BockajAndrej/AutomatedCentralHeating/README.md

# AutomatedCentralHeating

**Awarded 4th place in the national Student Professional Activity competition (SOČ) in the IT category (2022/2023).**

> All information about the product and its development can be found [here.](Dokumentacia)

## Final Products
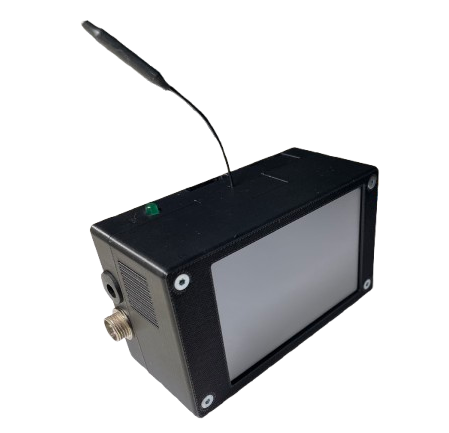
[picture p1: FOTO/Readme/MainUnitFront.png]

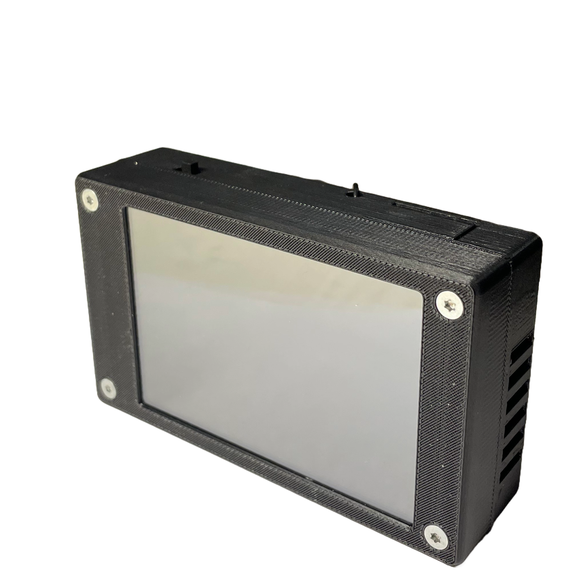
[picture p2: FOTO/Readme/SenderFront.png]


## Pages
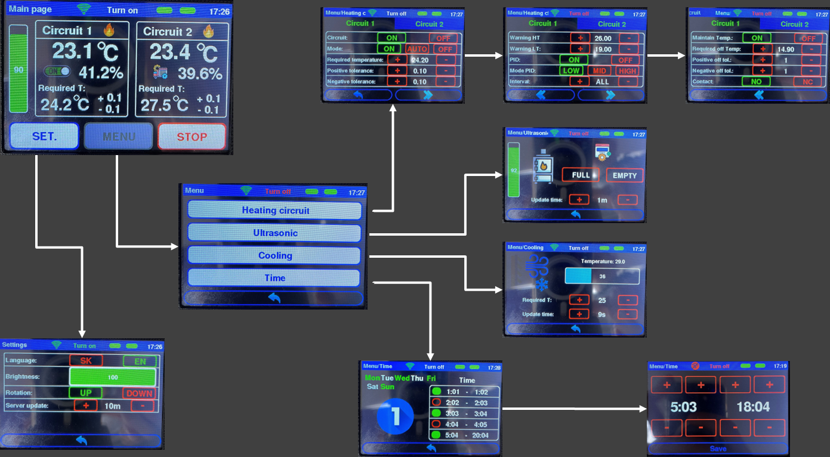
[picture p3: FOTO/Readme/pages.png]


## Algorithm diagrams

### Communication
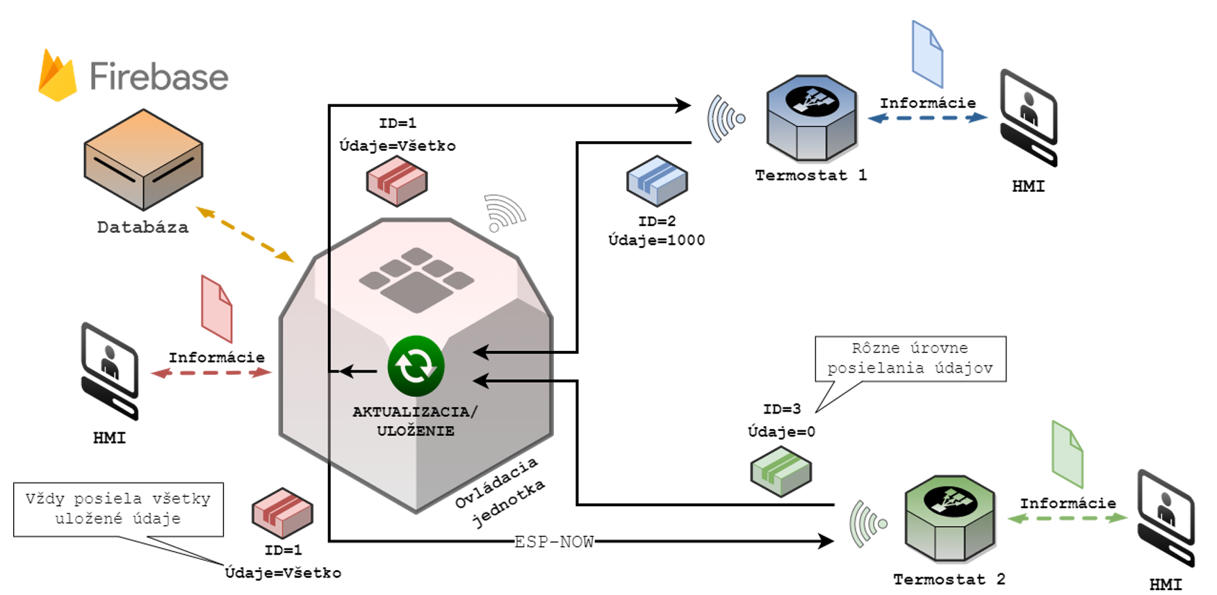
[picture p4: FOTO/Readme/Communication.png]

### PD regulation
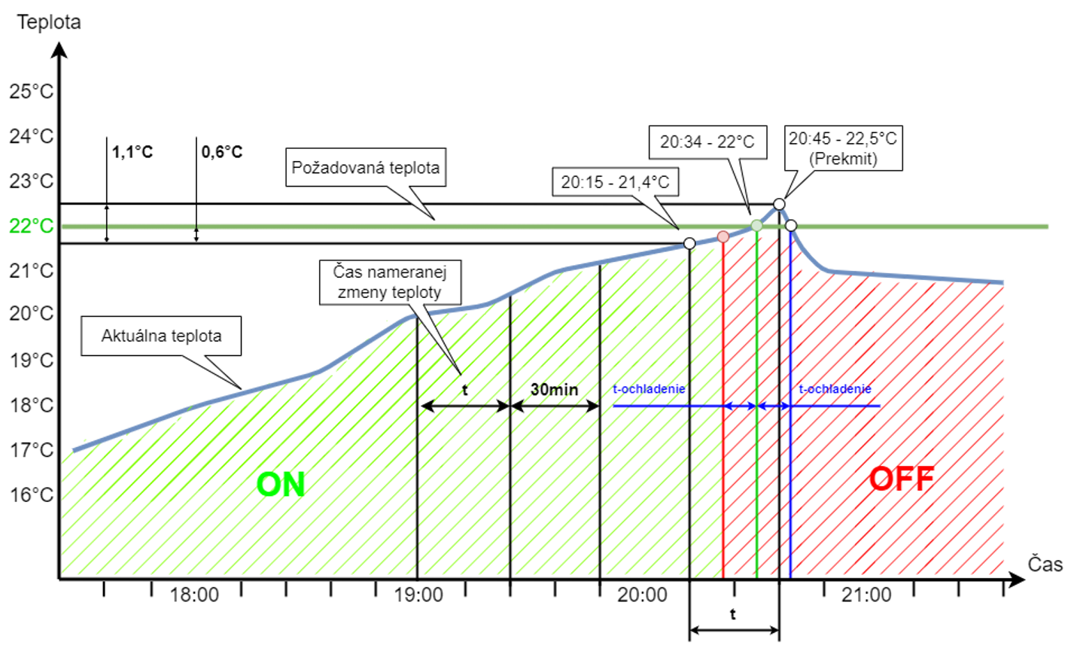
[picture p5: FOTO/Readme/PD_regulation.png]


## Program structure
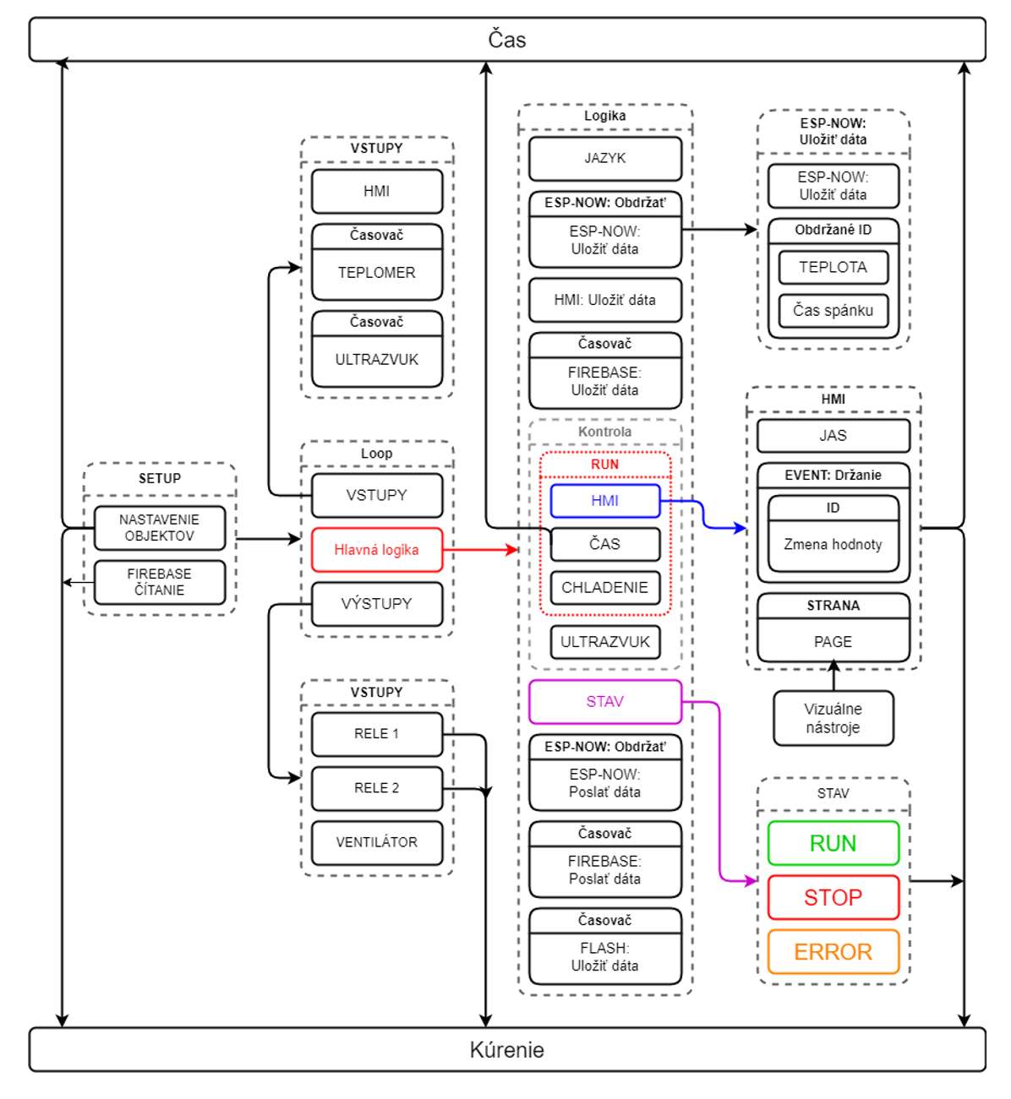
[picture p6: FOTO/Readme/ProgramStructure.png]


## DPS
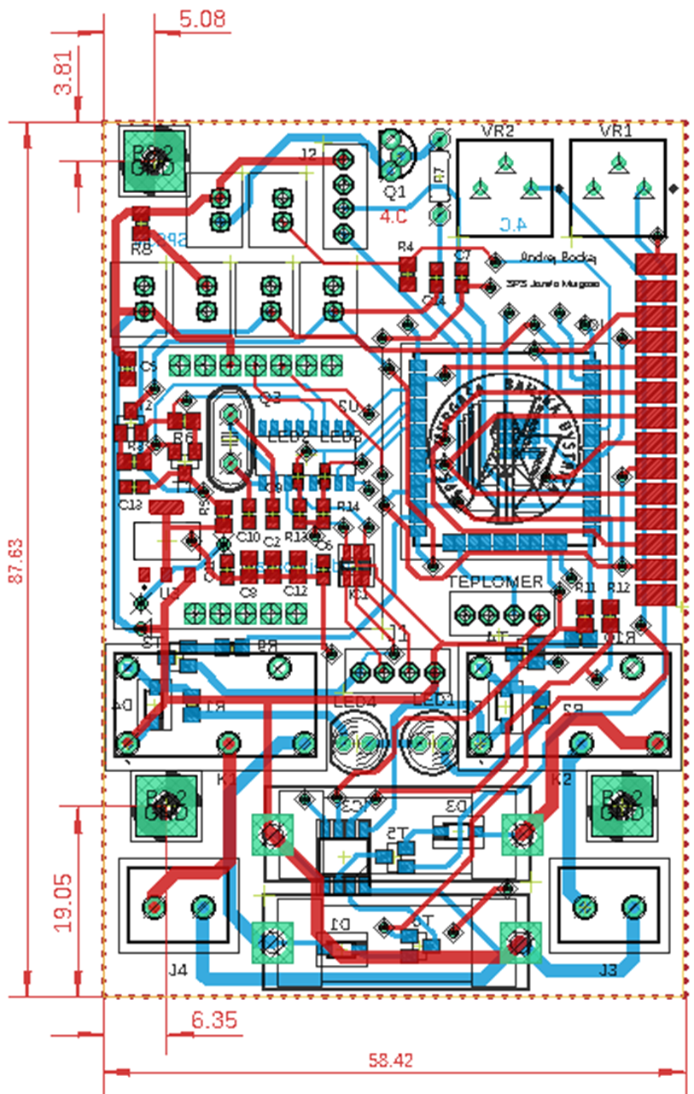
[picture p7: FOTO/Readme/MainUnitBrd.png]

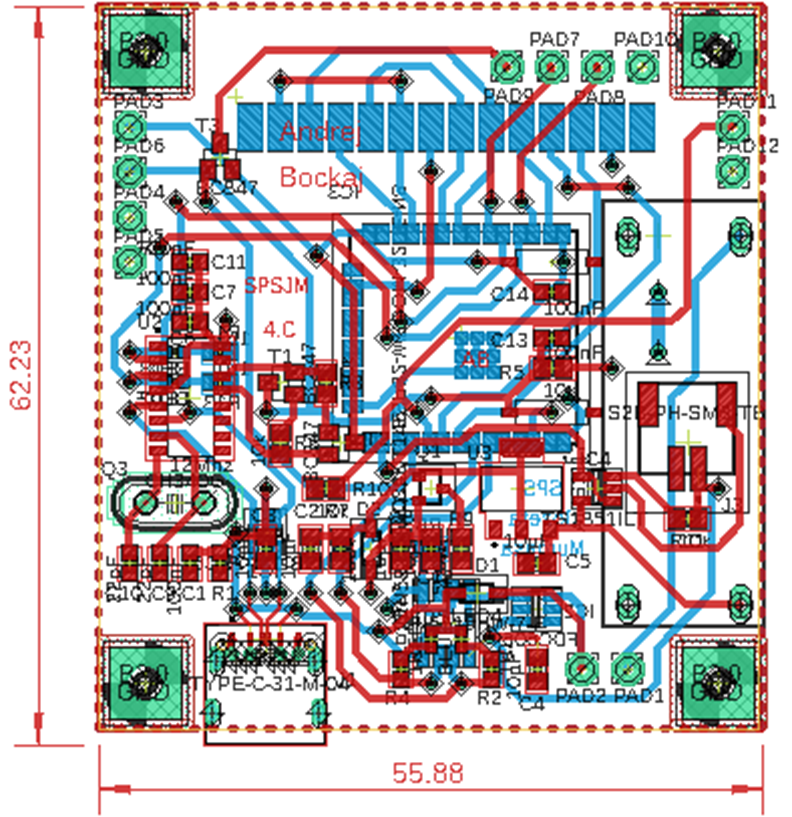
[picture p8: FOTO/Readme/SenderBrd.png]


## 3D models
### Main unit
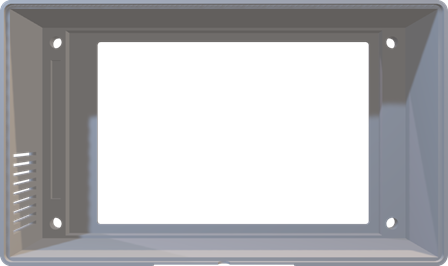
[picture p9: FOTO/Readme/MainUnitModelFront.png]

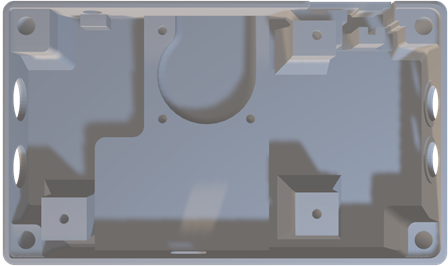
[picture p10: FOTO/Readme/MainUnitModelBack.png]

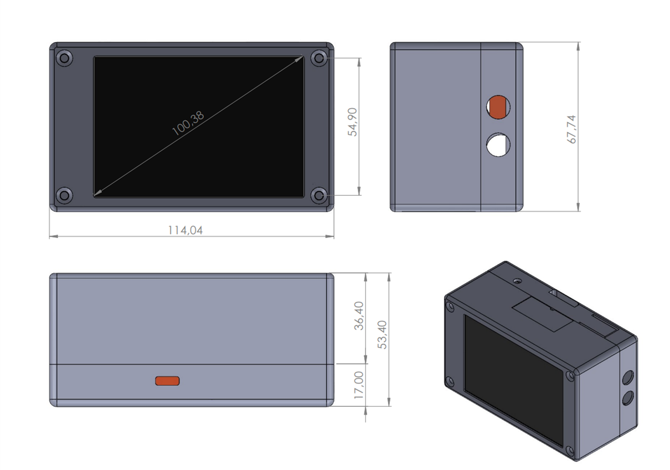
[picture p11: FOTO/Readme/MainUnitModelOut.png]


### Termostat
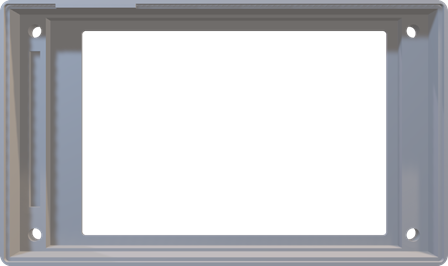
[picture p12: FOTO/Readme/SenderModelFront.png]

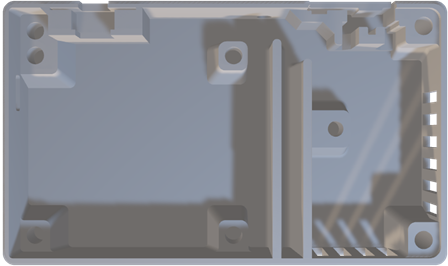
[picture p13: FOTO/Readme/SenderModelBack.png]

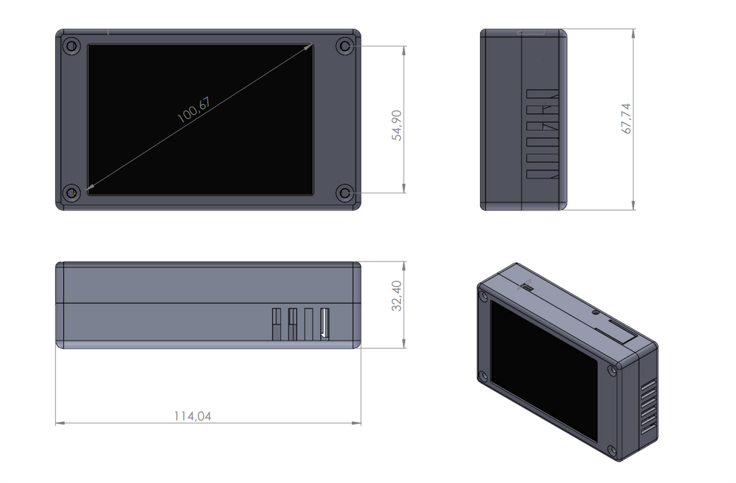
[picture p14: FOTO/Readme/SenderModelOut.png]


## Realisation
### Main unit
Popis prvého obrázka pre prístupnosť

### Termostat
Popis prvého obrázka pre prístupnosť
