BockajAndrej/AutomatedCentralHeating/Dokumentacia/Prezentácia SOČ.pdf

# ÚSTREDNÉHO KÚRENIA Krajské kolo SOČ

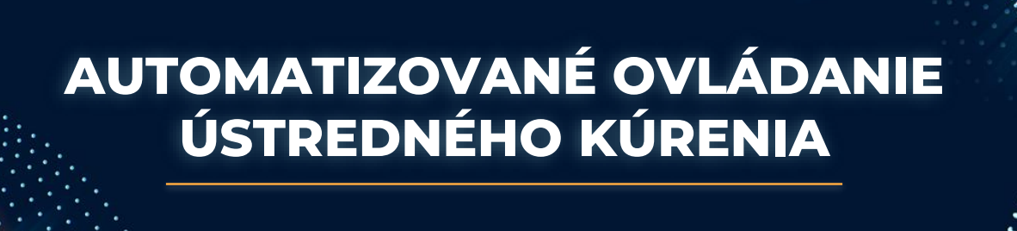
[picture p15: figure]
AUTOMATIZOVANÉ OVLÁDANIE ÚSTREDNÉHO KÚRENIA

Bočkaj Andrej 4.C SPŠ Jozefa Murgaša

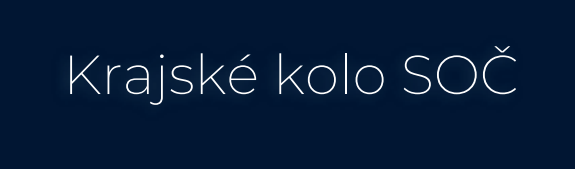
[picture p16: figure]
Krajské kolo SOČ

01

02 | 03 | 04
05

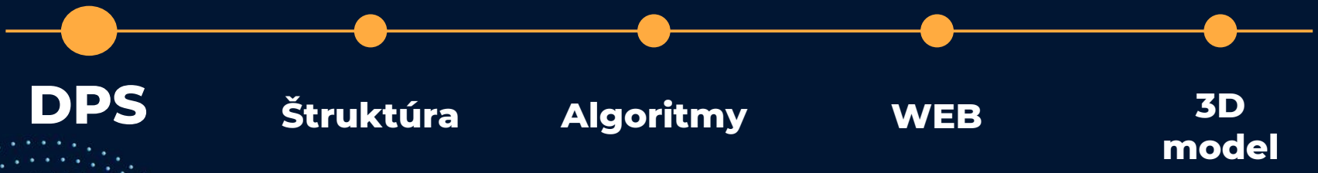
[picture p17: figure]
DPS; Štruktúra; Algoritmy; WEB; 3D model

01

# DPS

# DPS

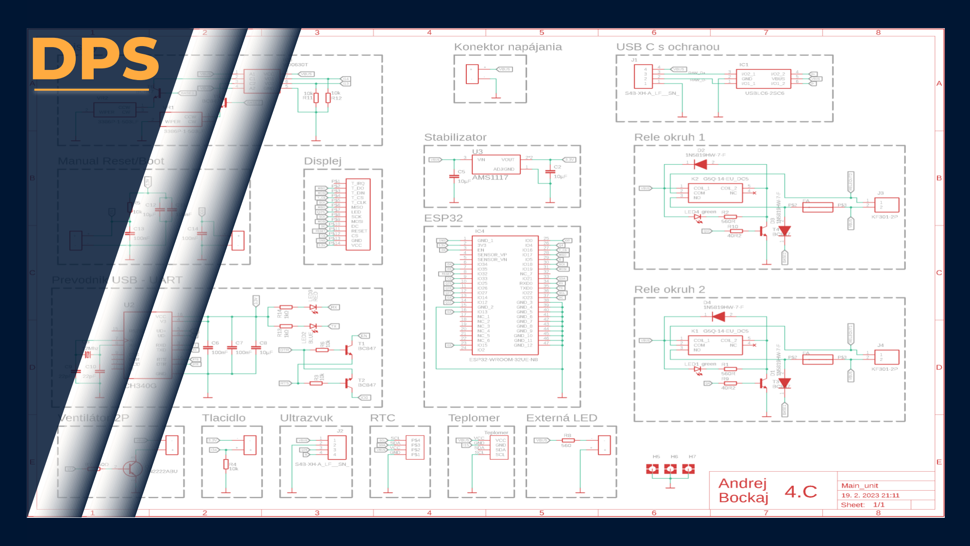
[picture p18: page 5]

# DPS

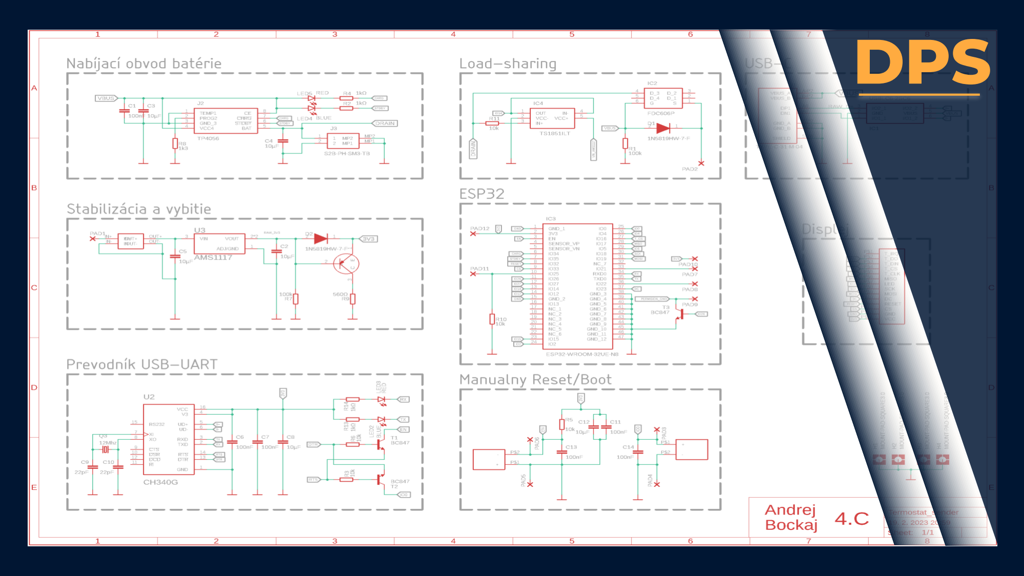
[picture p19: page 6]

01

02 | 03 | 04
05

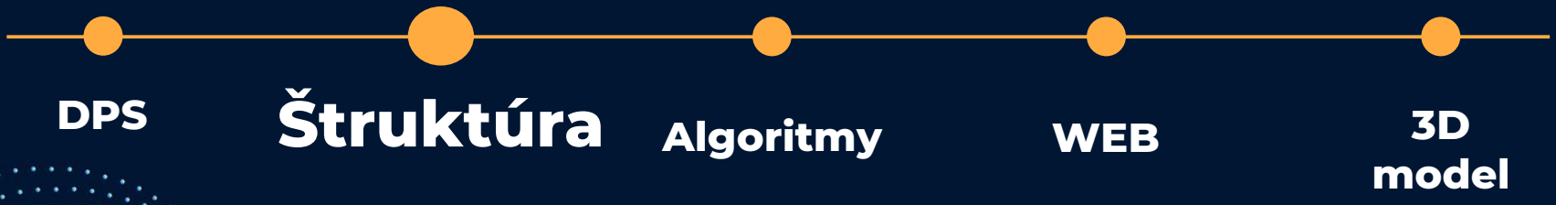
[picture p20: figure]
DPS; Štruktúra Algoritmy; WEB; 3D model

02

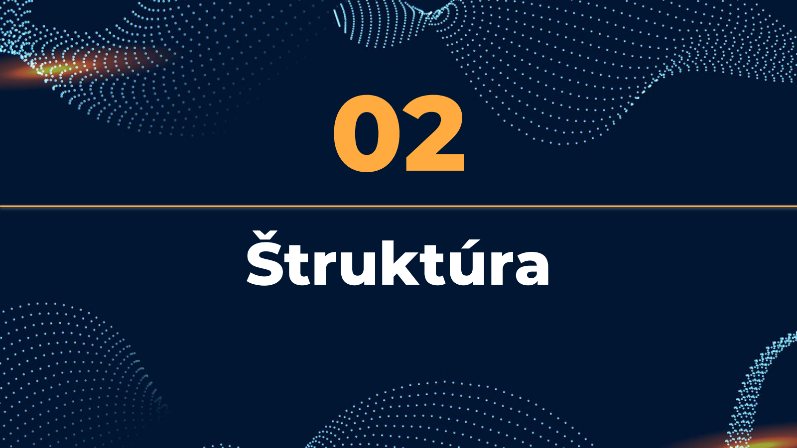
[picture p21: page 8]

# Štruktúra

## Štruktúra

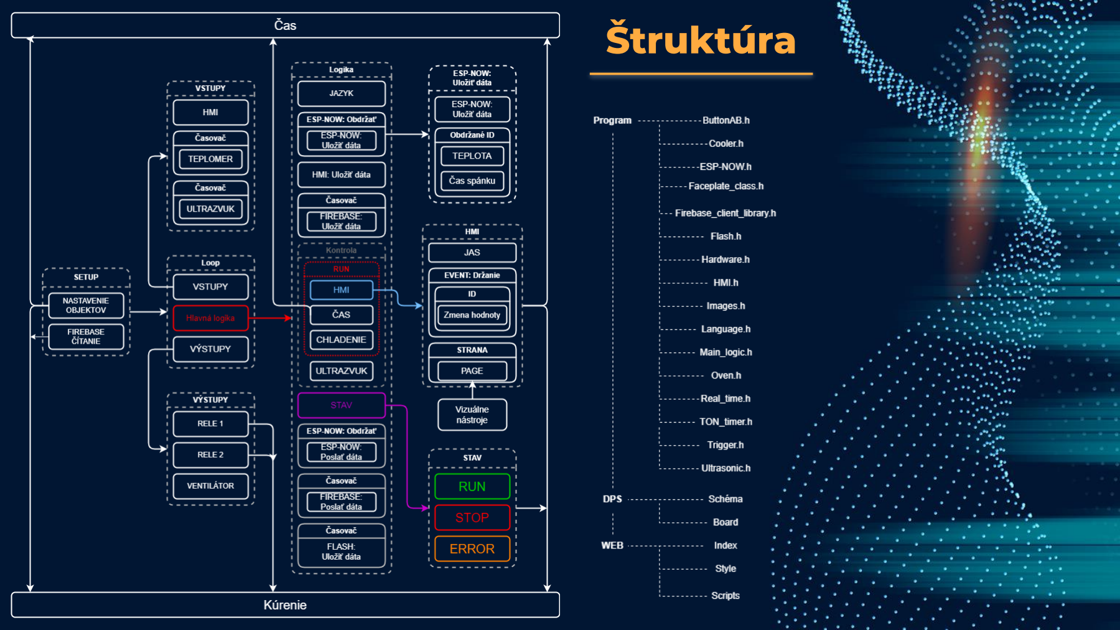
[picture p22: page 9]

02 | 03 | 04
05

01

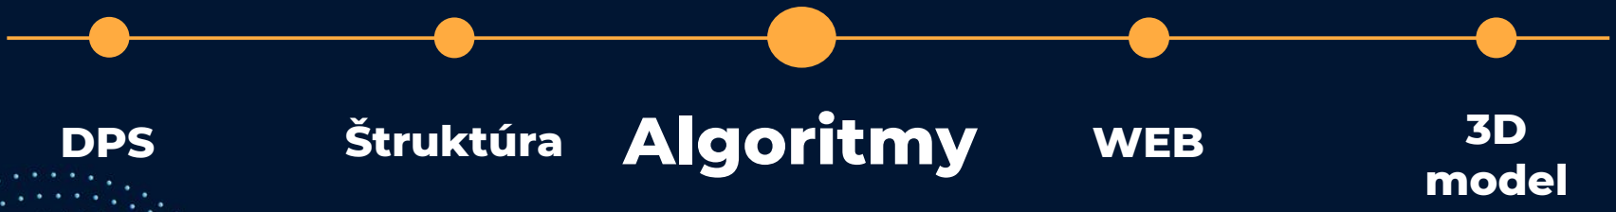
[picture p23: figure]
DPS; Štruktúra Algoritmy; WEB; 3D model

03

# Algoritmy

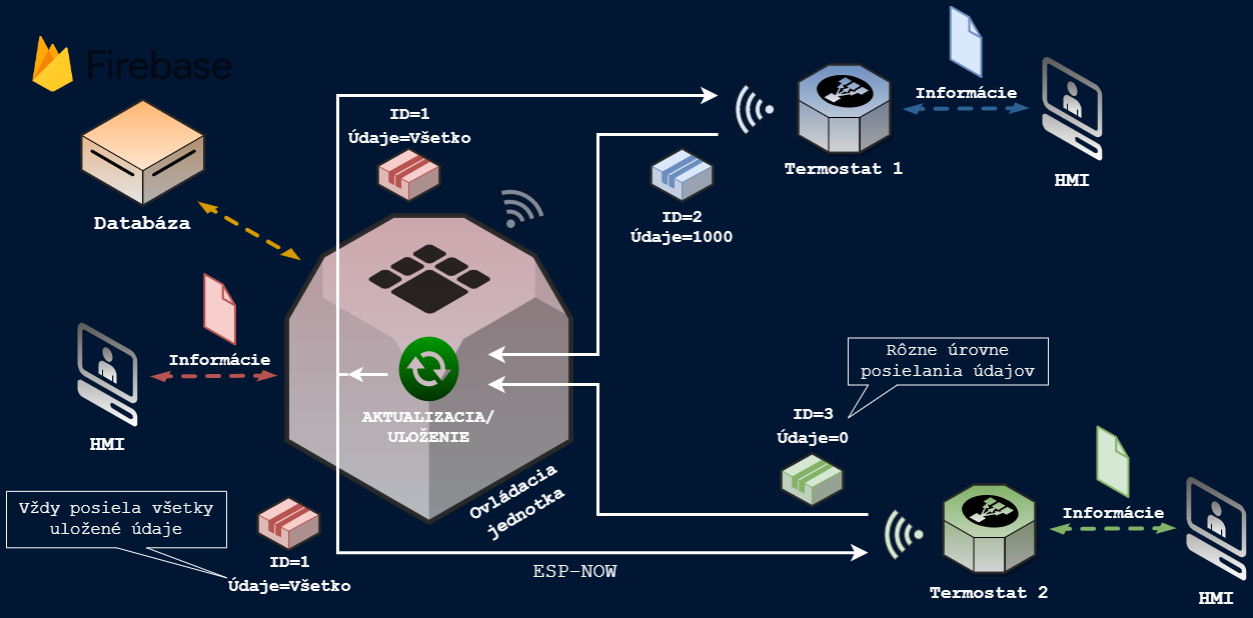
[picture p24: figure]
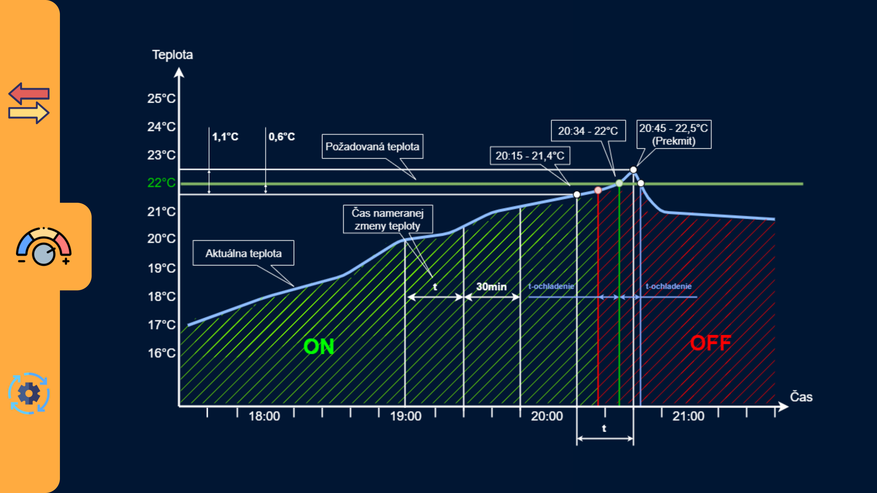
[picture p25: page 13]

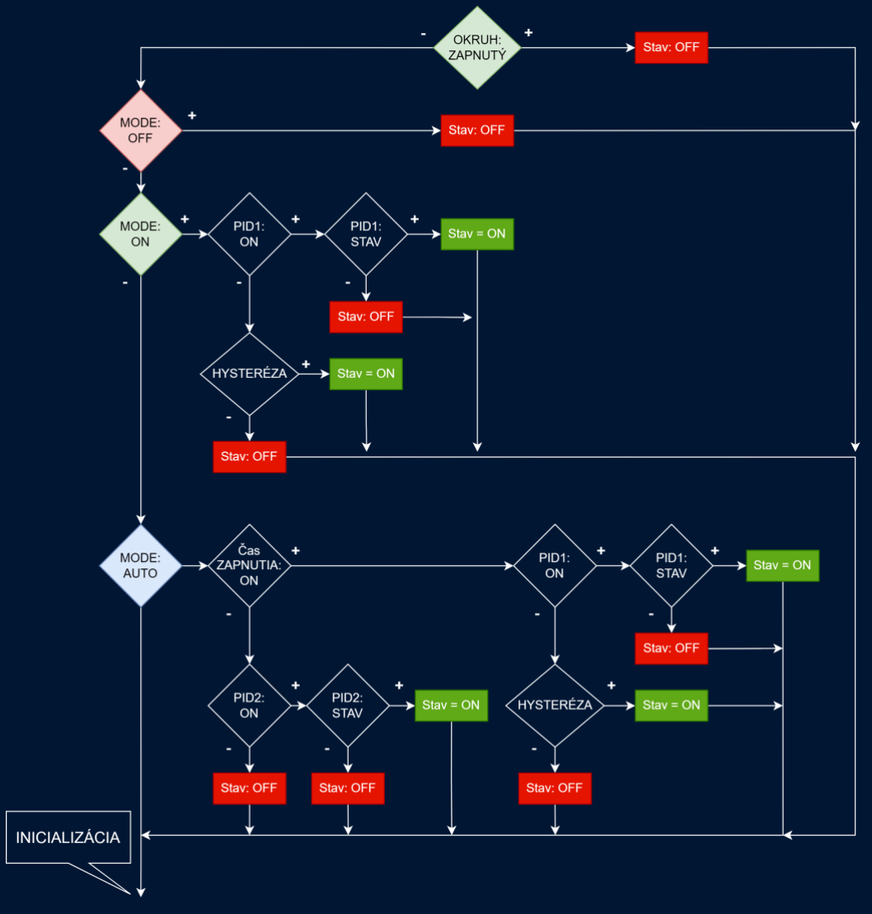
[picture p26: figure]

02 | 03 | 04
05

01

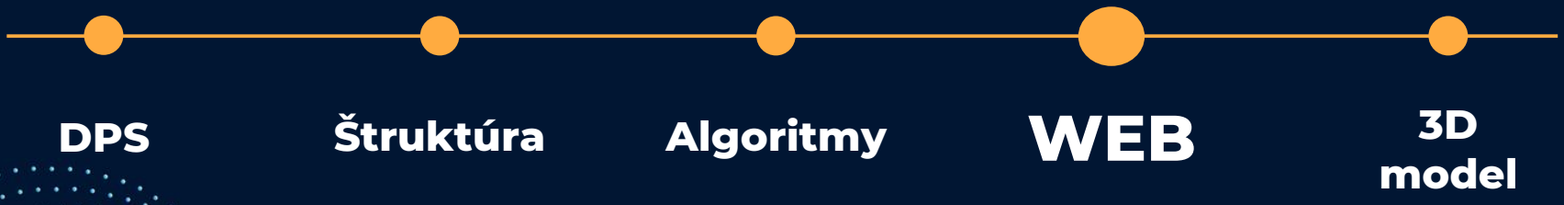
[picture p27: figure]
DPS; Štruktúra; Algoritmy; WEB; 3D model

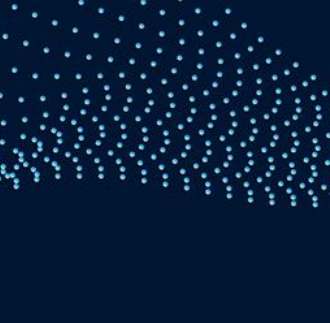
[picture p28: figure]

04

# WEB

# WEB

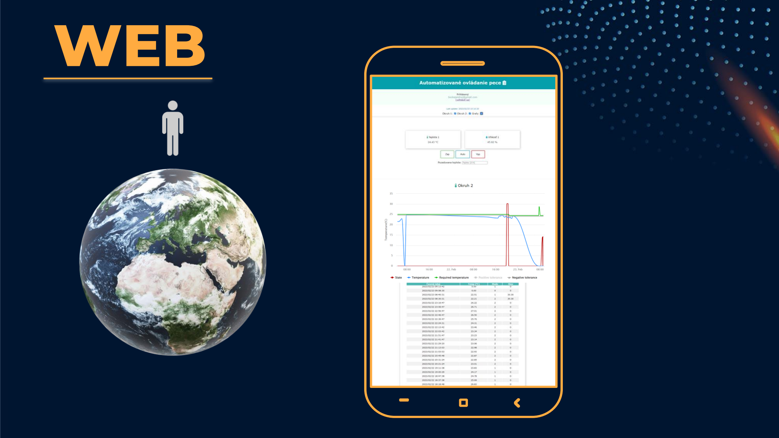
[picture p29: page 17]
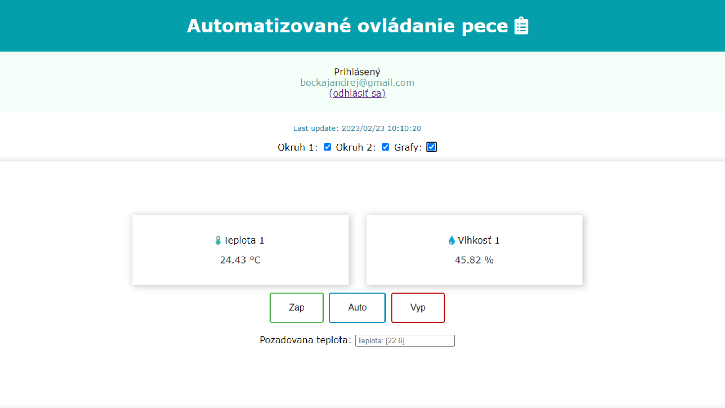
[picture p30: page 18]
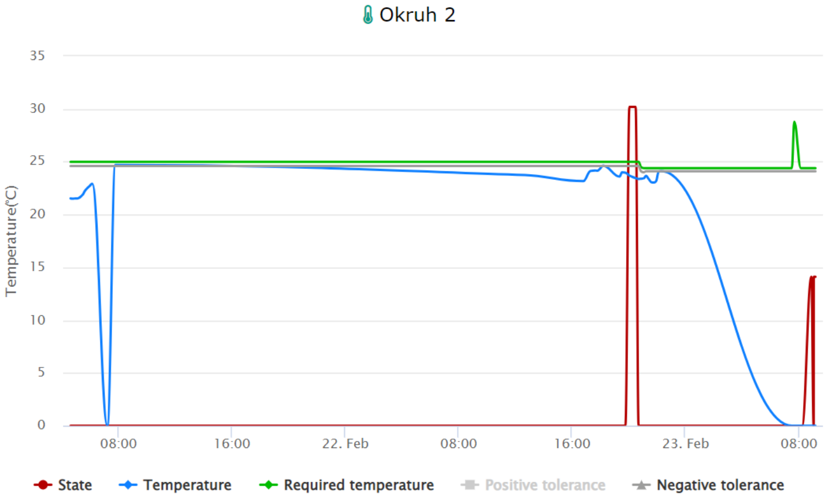
[picture p31: page 19]
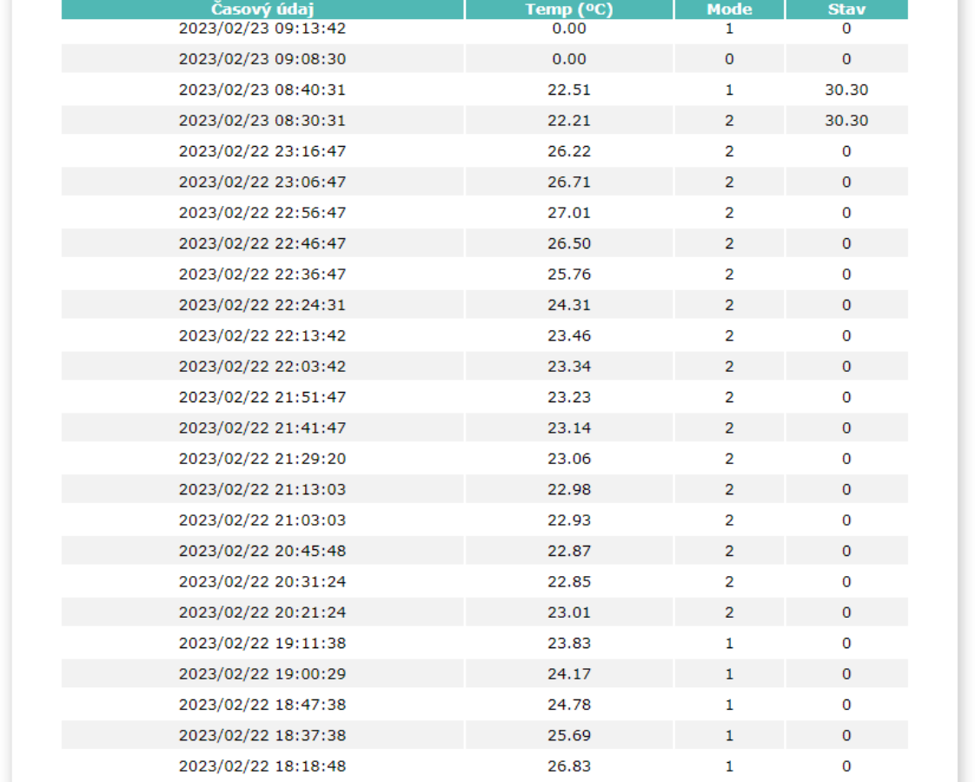
[picture p32: page 20]

DPS

02 | 03 | 04
Štruktúra | Algoritmy | WEB

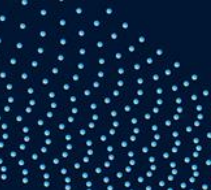
[picture p33: figure]

05

3D

## model

01

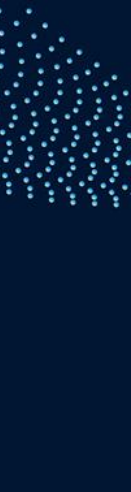
[picture p34: figure]

05

3D

# model

# 3D model

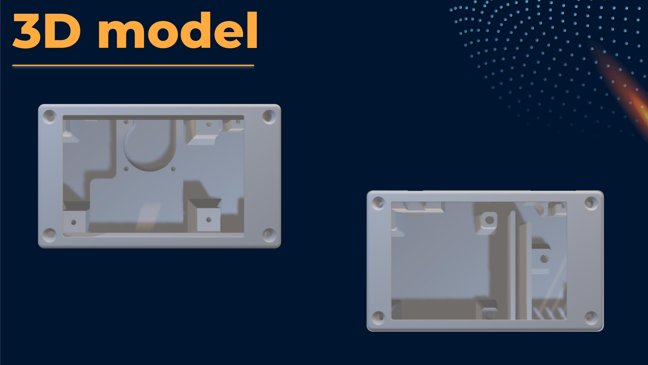
[picture p35: page 23]

# 3D model

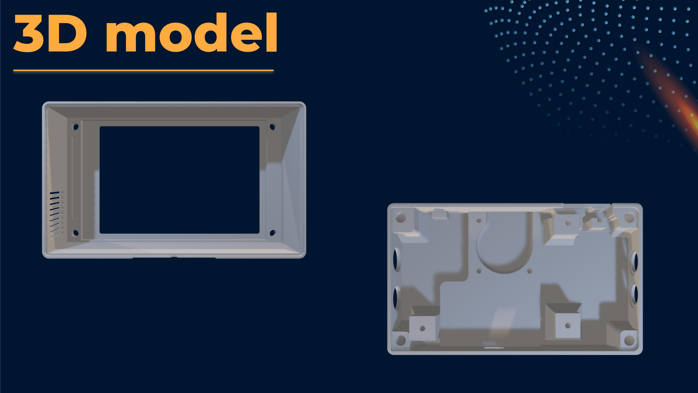
[picture p36: page 24]

# 3D model

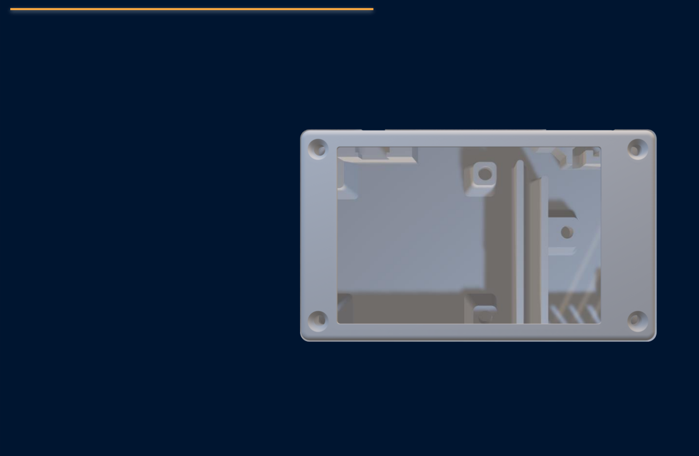
[picture p37: figure]

# 3D model

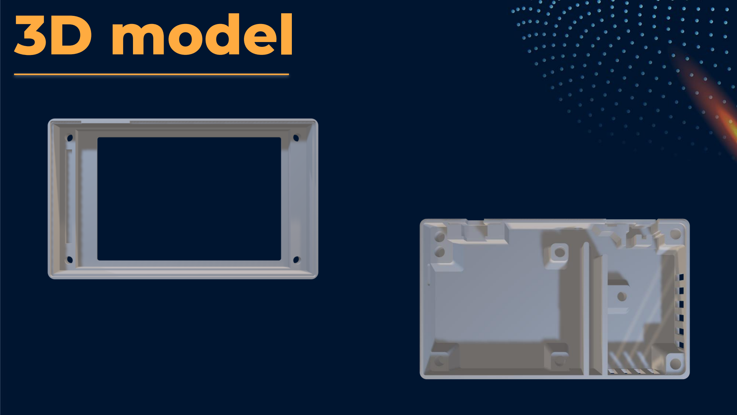
[picture p38: page 26]

# 3D model-Realizácia

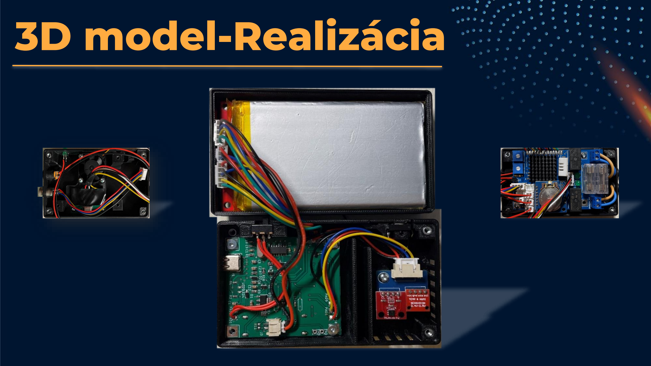
[picture p39: page 27]

# 3D model-Realizácia

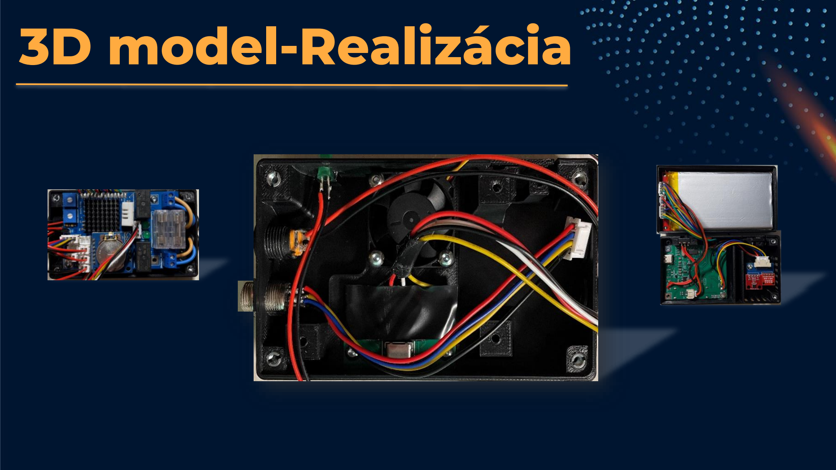
[picture p40: page 28]

# 3D model-Realizácia

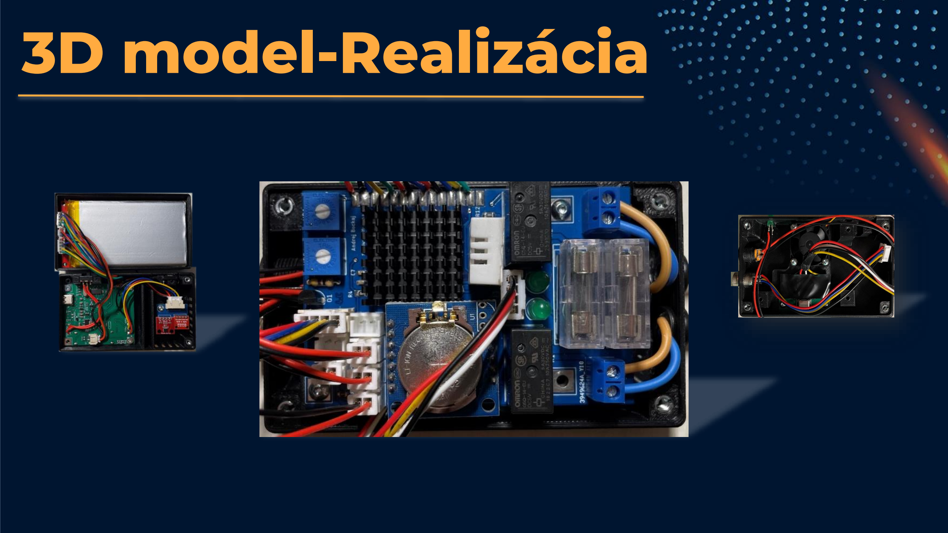
[picture p41: page 29]
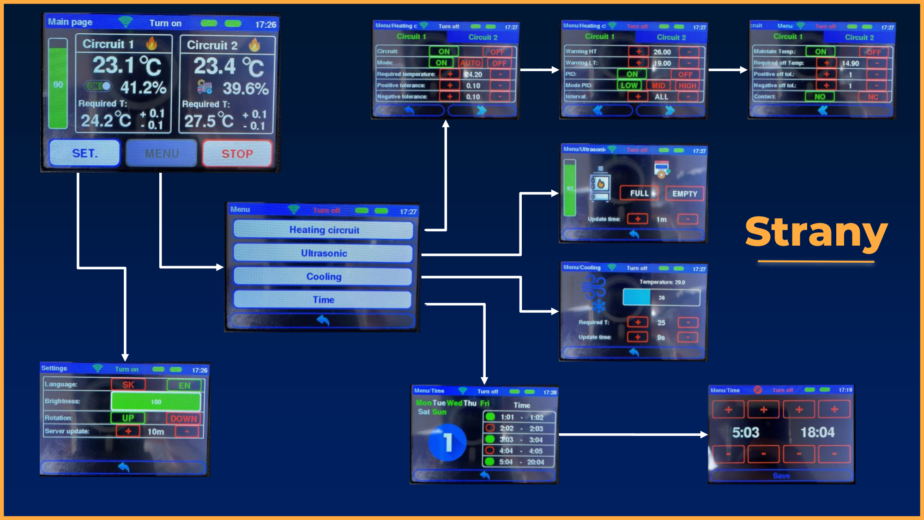
[picture p42: page 30]

# Strany

## Časová náročnosť vývoja zariadenia

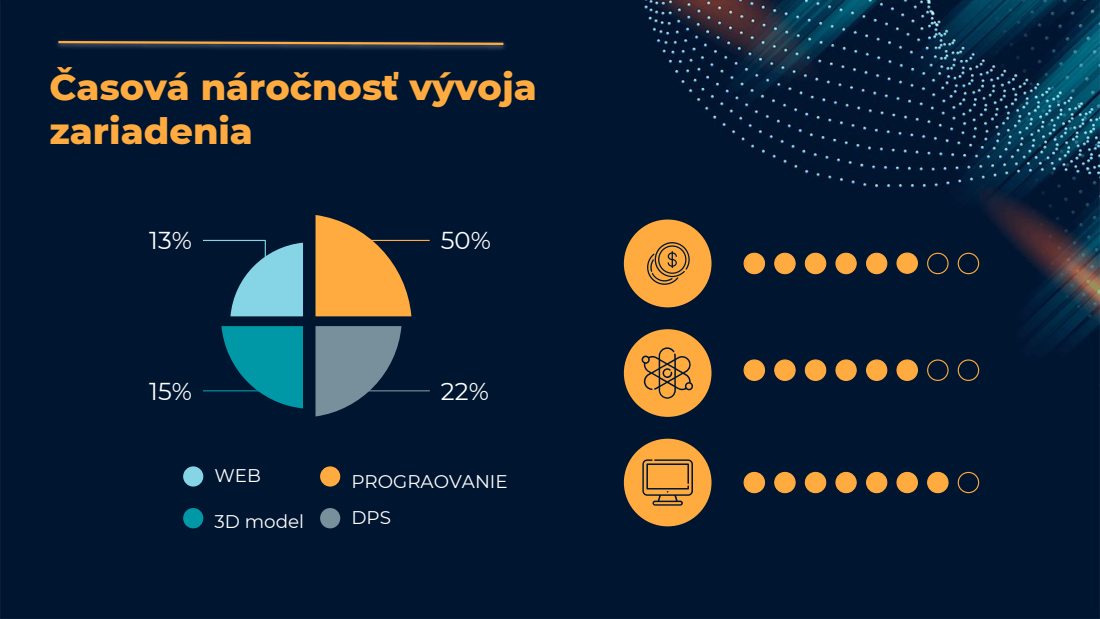
[picture p43: page 31]
PROGRAOVANIE; WEB; 3D model; DPS

# Ďakujem za pozornosť

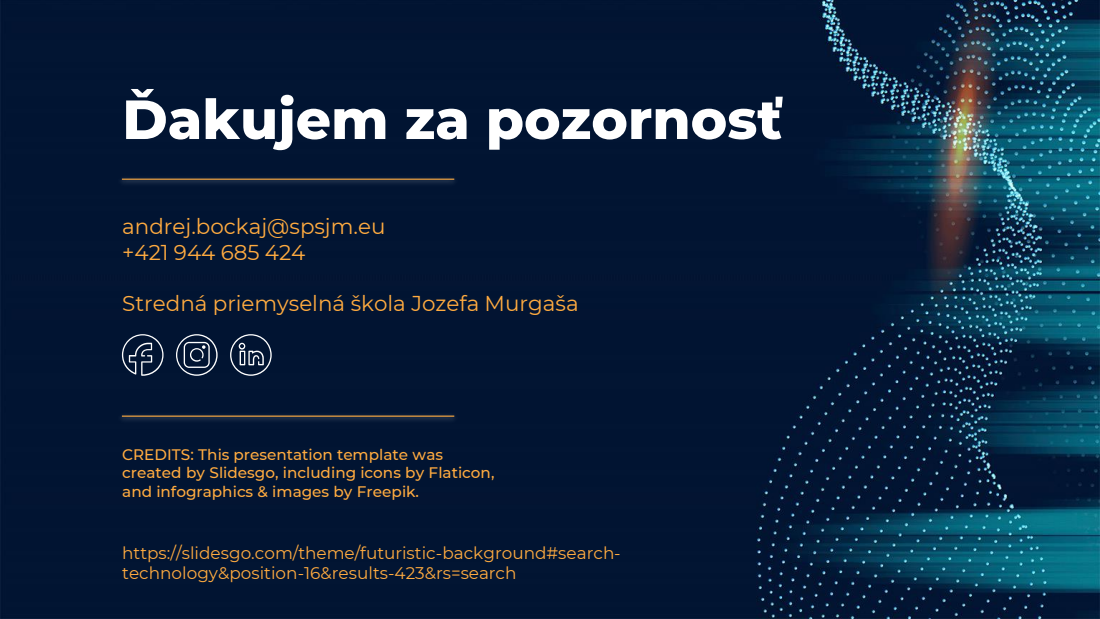
[picture p44: page 32]

andrej.bockaj@spsjm.eu

Stredná priemyselná škola Jozefa Murgaša

CREDITS: This presentation template was
created by Slidesgo, (http://bit.ly/2Tynxth) including icons by Flaticon, (http://bit.ly/2TyoMsr)
and infographics & images by Freepik. (http://bit.ly/2TtBDfr)

https://slidesgo.com/theme/futuristic-background#search-
technology&position-16&results-423&rs=search
