BockajAndrej/AutomatedCentralHeating/MAIN_PROGRAM/Main_unit_termostat0.2/HMI.h

#include "FS.h"
#include <TFT_eSPI.h>
#include <SPI.h>

#include "Images.h"

#include "Faceplate_Class.h"

#define CALIBRATION_FILE "/TouchCalData2"

class HMI {
private:
  TFT_eSPI* tft = new TFT_eSPI();
  TFT_eSprite* img = new TFT_eSprite(tft);
  TFT_eSprite* img_icon = new TFT_eSprite(tft);
  TFT_eSprite* img_background = new TFT_eSprite(tft);

  Time* real_time;
  Oven* oven_1;
  Oven* oven_2;
  Ultrasonic* ultrasonic;
  Cooler* cooler;
  ESP_NOW* esp_now;
  Flash* flash;
  ButtonAB* on_off_Btn;
  Firebase_class* firebase;

  Faceplate_Class* Faceplate = new Faceplate_Class(tft, img, img_icon, img_background);

  Language* Message = new Language();

  TON timer_for_touch = TON(200);

  int Wifi_connection;

  bool REPEAT_CAL;
  int Server_update_time;

  enum current_mode {
    Nominal_run = 1,
    Ground_position = 2,
    Error = 10
  };
  current_mode Current_mode;

  struct alarm {
    bool activated;
    Language* message = new Language();
  };
  alarm Alarm;

  struct display_property {
    int Width;
    int Height;
    int LOOP_PERIOD;
    short Rotation;
    int Text_color;
    unsigned long UpdateTimeHMI_LOOP;
    bool first_draw;
    unsigned long Refresh_time;
    struct Pressing_struct {
      int Enable_timer;
      unsigned long Time;
      int Count;
      int ID;
    };
    Pressing_struct Pressing;
    struct Brightness_struct {
      int Pin;
      int PWMfreq;
      int PWMChannel;
      int PWMresolution;
      int Value;
    };
    Brightness_struct Brightness;
    struct color {
      int Transparent[3] = { 999, 999, 999 };
      int Background[3];
      int Text[3];
      int Focused[3];
      int Red[3] = { 255, 0, 0 };
      int Green[3] = { 0, 255, 0 };
      int Lite_blue[3] = { 0, 165, 255 };
      int Blue[3] = { 0, 0, 255 };
      int Dark_blue[3] = { 0, 0, 153 };
      int Black[3] = { 0, 0, 0 };
      int White[3] = { 255, 255, 255 };
      int Yellow[3] = { 255, 255, 0 };
      int Orange[3] = { 255, 100, 0 };
    };
    color Color;
  };
  display_property Property;

  enum Page {
    Main_page = 1,
    Menu = 2,
    Settings = 3,
    Heating_circruit_ = 10,
    Ultrasonic_ = 11,
    Temperature_sensor_ = 12,
    Time_ = 13
  };
  Page page;
  Page prev_page;

public:
  HMI(Time* real_time, Oven* oven_1, Oven* oven_2, Ultrasonic* ultrasonic, Cooler* cooler, ESP_NOW* esp_now, Flash* flash, ButtonAB* on_off_Btn, Firebase_class* firebase) {
    this->real_time = real_time;
    this->oven_1 = oven_1;
    this->oven_2 = oven_2;
    this->ultrasonic = ultrasonic;
    this->cooler = cooler;
    this->esp_now = esp_now;
    this->flash = flash;
    this->on_off_Btn = on_off_Btn;
    this->firebase = firebase;

    page = Main_page;
    prev_page = Menu;

    Alarm.activated = false;

    REPEAT_CAL = false;
    Server_update_time = 10;

    Property.UpdateTimeHMI_LOOP = 0;
    Property.LOOP_PERIOD = 20;
    Property.Width = 480;
    Property.Height = 320;
    Property.Rotation = 3;
    Property.first_draw = true;

    Property.Pressing.Time = 0;
    Property.Pressing.Enable_timer = false;

    Property.Brightness.PWMfreq = 5000;
    Property.Brightness.PWMChannel = 1;
    Property.Brightness.PWMresolution = 8;
    Property.Brightness.Value = 255;

    Property.Color.Transparent[0] = 999;
    Property.Color.Background[0] = 0;
    Property.Color.Background[1] = 0;
    Property.Color.Background[2] = 0;
    Property.Color.Text[0] = 255;
    Property.Color.Text[1] = 255;
    Property.Color.Text[2] = 255;
    Property.Color.Focused[0] = 0;
    Property.Color.Focused[1] = 255;
    Property.Color.Focused[2] = 0;

    Touch.x = 0;
    Touch.y = 0;
    Touch.raw_Pressed = false;
    Touch.UpdateTimeHMI_Touch = 0;
    Touch.Pressed = false;
    Touch.prev_Pressed = Touch.Pressed;
    Touch.Pressing_period = 80;
    Touch.Releast = false;

    Settings_str.prev_language = Message->get_language();

    TopBar.Height = 30;

    MainPage.prev_heating_1 = oven_1->get_Heating();
    MainPage.prev_heating_2 = oven_2->get_Heating();

    Settings_str.Reset_value = 1;

    Heating_circuit.Circuit = true;
    Heating_circuit.prev_Circuit = Heating_circuit.Circuit;
    Heating_circuit.Page = 1;

    Time_Struct.Page_ = true;
  }
  void Setup(int Pin) {
    // configure LED PWM functionalitites
    ledcSetup(Property.Brightness.PWMChannel, Property.Brightness.PWMfreq, Property.Brightness.PWMresolution);
    // attach the channel to the GPIO to be controlled
    ledcAttachPin(Pin, Property.Brightness.PWMChannel);

    ledcWrite(Property.Brightness.PWMChannel, Property.Brightness.Value);

    Property.Brightness.Pin = Pin;

    tft->init();
    tft->setSwapBytes(true);
    img->setColorDepth(8);  // Set colour depth of Sprite to 8 (or 16) bits
    img_icon->setSwapBytes(true);

    Property.Rotation = flash->get_Flash(44);
    tft->setRotation(Property.Rotation);

    // Calibrate the touch screen and retrieve the scaling factors
    REPEAT_CAL = (bool)flash->get_Flash(45);
    touch_calibrate();
    REPEAT_CAL = false;
    if ((bool)flash->get_Flash(45)) flash->set_Flash(45, REPEAT_CAL);

    tft->setTextSize(1);
    tft->setTextColor(tft->color565(Property.Color.Text[0], Property.Color.Text[1], Property.Color.Text[2]), tft->color565(Property.Color.Background[0], Property.Color.Background[1], Property.Color.Background[2]));
    tft->fillScreen(tft->color565(Property.Color.Background[0], Property.Color.Background[1], Property.Color.Background[2]));

    Current_mode = (HMI::current_mode)flash->get_Flash(0);
    if (flash->get_Flash(1)) Message->Set_language("EN");
    else Message->Set_language("SK");

    Server_update_time = flash->get_Flash(49);

    Property.UpdateTimeHMI_LOOP = millis();
    Touch.UpdateTimeHMI_Touch = millis();
    Property.Refresh_time = millis();
  }
  bool Refresh(bool Draw, int Wifi_connection) {

    this->Wifi_connection = Wifi_connection;

    if ((Current_mode == Nominal_run) && (page != Settings)) page = Main_page;

    ledcWrite(Property.Brightness.PWMChannel, Property.Brightness.Value);

    if (Draw) Property.first_draw = true;

    if (((Property.Pressing.Time + Property.Pressing.Count) <= millis()) && Property.Pressing.Enable_timer) {
      switch (Property.Pressing.ID) {
        case 1:
          if (Heating_circuit.Circuit) oven_1->set_Required_T(oven_1->get_Required_T() + 0.1);
          else oven_2->set_Required_T(oven_2->get_Required_T() + 0.1);
          break;
        case 2:
          if (Heating_circuit.Circuit) oven_1->set_Required_T(oven_1->get_Required_T() - 0.1);
          else oven_2->set_Required_T(oven_2->get_Required_T() - 0.1);
          break;
        case 3:
          if (Heating_circuit.Circuit) oven_1->set_Positive_tolerance(oven_1->get_Positive_tolerance() + 0.1);
          else oven_2->set_Positive_tolerance(oven_2->get_Positive_tolerance() + 0.1);
          break;
        case 4:
          if (Heating_circuit.Circuit) oven_1->set_Positive_tolerance(oven_1->get_Positive_tolerance() - 0.1);
          else oven_2->set_Positive_tolerance(oven_2->get_Positive_tolerance() - 0.1);
          break;
        case 5:
          if (Heating_circuit.Circuit) oven_1->set_Negative_tolerance(oven_1->get_Negative_tolerance() + 0.1);
          else oven_2->set_Negative_tolerance(oven_2->get_Negative_tolerance() + 0.1);
          break;
        case 6:
          if (Heating_circuit.Circuit) oven_1->set_Negative_tolerance(oven_1->get_Negative_tolerance() - 0.1);
          else oven_2->set_Negative_tolerance(oven_2->get_Negative_tolerance() - 0.1);
          break;
        case 7:
          if (Heating_circuit.Circuit) oven_1->set_Upper_limit(oven_1->get_Upper_limit() + 1);
          else oven_2->set_Upper_limit(oven_2->get_Upper_limit() + 1);
          break;
        case 8:
          if (Heating_circuit.Circuit) oven_1->set_Upper_limit(oven_1->get_Upper_limit() - 1);
          else oven_2->set_Upper_limit(oven_2->get_Upper_limit() - 1);
          break;
        case 9:
          if (Heating_circuit.Circuit) oven_1->set_Lower_limit(oven_1->get_Lower_limit() + 1);
          else oven_2->set_Lower_limit(oven_2->get_Lower_limit() + 1);
          break;
        case 10:
          if (Heating_circuit.Circuit) oven_1->set_Lower_limit(oven_1->get_Lower_limit() - 1);
          else oven_2->set_Lower_limit(oven_2->get_Lower_limit() - 1);
          break;
        case 21:
          if (Property.Pressing.Count < 250) {
            Time_Struct.Page_ = false;
            Time_Struct.ID = 0;
          }
          break;
        case 22:
          if (Property.Pressing.Count < 250) {
            Time_Struct.Page_ = false;
            Time_Struct.ID = 1;
          }
          break;
        case 23:
          if (Property.Pressing.Count < 250) {
            Time_Struct.Page_ = false;
            Time_Struct.ID = 2;
          }
          break;
        case 24:
          if (Property.Pressing.Count < 250) {
            Time_Struct.Page_ = false;
            Time_Struct.ID = 3;
          }
          break;
        case 25:
          if (Property.Pressing.Count < 250) {
            Time_Struct.Page_ = false;
            Time_Struct.ID = 4;
          }
          break;
        case 26:
          if (Property.Pressing.Count < 250) {
            Time_Struct.Page_ = false;
            Time_Struct.ID = 0;
          }
          break;
        case 27:
          if (Property.Pressing.Count < 250) {
            Time_Struct.Page_ = false;
            Time_Struct.ID = 1;
          }
          break;
        case 28:
          if (Property.Pressing.Count < 250) {
            Time_Struct.Page_ = false;
            Time_Struct.ID = 2;
          }
          break;
        case 29:
          if (Property.Pressing.Count < 250) {
            Time_Struct.Page_ = false;
            Time_Struct.ID = 3;
          }
          break;
        case 30:
          if (Property.Pressing.Count < 250) {
            Time_Struct.Page_ = false;
            Time_Struct.ID = 4;
          }
          break;
        case 31:
          real_time->set_Interval_heating(Time_Struct.Which, true, Time_Struct.ID, (real_time->get_Interval_heating(Time_Struct.Which, true, Time_Struct.ID) + 60));
          break;
        case 32:
          real_time->set_Interval_heating(Time_Struct.Which, true, Time_Struct.ID, (real_time->get_Interval_heating(Time_Struct.Which, true, Time_Struct.ID) - 60));
          break;
        case 33:
          real_time->set_Interval_heating(Time_Struct.Which, true, Time_Struct.ID, (real_time->get_Interval_heating(Time_Struct.Which, true, Time_Struct.ID) + 1));
          break;
        case 34:
          real_time->set_Interval_heating(Time_Struct.Which, true, Time_Struct.ID, (real_time->get_Interval_heating(Time_Struct.Which, true, Time_Struct.ID) - 1));
          break;
        case 35:
          real_time->set_Interval_heating(Time_Struct.Which, false, Time_Struct.ID, (real_time->get_Interval_heating(Time_Struct.Which, false, Time_Struct.ID) + 60));
          break;
        case 36:
          real_time->set_Interval_heating(Time_Struct.Which, false, Time_Struct.ID, (real_time->get_Interval_heating(Time_Struct.Which, false, Time_Struct.ID) - 60));
          break;
        case 37:
          real_time->set_Interval_heating(Time_Struct.Which, false, Time_Struct.ID, (real_time->get_Interval_heating(Time_Struct.Which, false, Time_Struct.ID) + 1));
          break;
        case 38:
          real_time->set_Interval_heating(Time_Struct.Which, false, Time_Struct.ID, (real_time->get_Interval_heating(Time_Struct.Which, false, Time_Struct.ID) - 1));
          break;
        case 40:
          ultrasonic->set_Update_time(ultrasonic->get_Update_time() + 60000);
          break;
        case 41:
          ultrasonic->set_Update_time(ultrasonic->get_Update_time() - 60000);
          break;
        case 42:
          if (Heating_circuit.Circuit) oven_1->set_Heating_Interval(oven_1->get_Heating_Interval() + 1);
          else oven_2->set_Heating_Interval(oven_2->get_Heating_Interval() + 1);
          break;
        case 43:
          if (Heating_circuit.Circuit) oven_1->set_Heating_Interval(oven_1->get_Heating_Interval() - 1);
          else oven_2->set_Heating_Interval(oven_2->get_Heating_Interval() - 1);
          break;
        case 46:
          if (Heating_circuit.Circuit) oven_1->set_Required_T_off(oven_1->get_Required_T_off() + 0.1);
          else oven_2->set_Required_T_off(oven_2->get_Required_T_off() + 0.1);
          break;
        case 47:
          if (Heating_circuit.Circuit) oven_1->set_Required_T_off(oven_1->get_Required_T_off() - 0.1);
          else oven_2->set_Required_T_off(oven_2->get_Required_T_off() - 0.1);
          break;
        case 48:
          if (Heating_circuit.Circuit) oven_1->set_Positive_tolerance_off(oven_1->get_Positive_tolerance_off() + 1);
          else oven_2->set_Positive_tolerance_off(oven_2->get_Positive_tolerance_off() + 1);
          break;
        case 49:
          if (Heating_circuit.Circuit) oven_1->set_Positive_tolerance_off(oven_1->get_Positive_tolerance_off() - 1);
          else oven_2->set_Positive_tolerance_off(oven_2->get_Positive_tolerance_off() - 1);
          break;
        case 50:
          if (Heating_circuit.Circuit) oven_1->set_Negative_tolerance_off(oven_1->get_Negative_tolerance_off() + 1);
          else oven_2->set_Negative_tolerance_off(oven_2->get_Negative_tolerance_off() + 1);
          break;
        case 51:
          if (Heating_circuit.Circuit) oven_1->set_Negative_tolerance_off(oven_1->get_Negative_tolerance_off() - 1);
          else oven_2->set_Negative_tolerance_off(oven_2->get_Negative_tolerance_off() - 1);
          break;
        case 60:
          cooler->set_Update_time(cooler->get_Update_time() + 1000);
          break;
        case 61:
          cooler->set_Update_time(cooler->get_Update_time() - 1000);
          break;
        case 62:
          cooler->set_Required_T(cooler->get_Required_T() + 1);
          break;
        case 63:
          cooler->set_Required_T(cooler->get_Required_T() - 1);
          break;
        case 64:
          set_Server_update_time(Server_update_time + 1);
          break;
        case 65:
          set_Server_update_time(Server_update_time - 1);
          break;
        case 66:
          Settings_str.Reset_value++;
          if(Settings_str.Reset_value > 4) Settings_str.Reset_value = 1;
          break;
        default:
          break;
      }
      Property.Pressing.Time = millis();
      if (Property.Pressing.Count > 210) Property.Pressing.Count = Property.Pressing.Count / 1.5;
      else if (Property.Pressing.Count < 210 && Property.Pressing.Count > 116) Property.Pressing.Count -= 15;
    }

    Property.Pressing.ID = 0;

    if (Property.Color.Background[0] == 0) {
      Property.Color.Text[0] = 255;
      Property.Color.Text[1] = 255;
      Property.Color.Text[2] = 255;
    } else {
      Property.Color.Text[0] = 0;
      Property.Color.Text[1] = 0;
      Property.Color.Text[2] = 0;
    }

    if (Property.UpdateTimeHMI_LOOP <= millis()) {
      Touch_detector();
      Property.Refresh_time = millis();
      Property.UpdateTimeHMI_LOOP = millis() + Property.LOOP_PERIOD;
      if (page != prev_page) {
        tft->fillScreen(tft->color565(Property.Color.Background[0], Property.Color.Background[1], Property.Color.Background[2]));
        Property.first_draw = true;
        prev_page = page;
      }
      fcTop_bar();
      switch (page) {
        case 1:
          if (fcMain_page() == false) {
            Alarm.activated = true;
            Alarm.message->set_Message("Displej/Refresh: Error = Id out of range", "Displej/Refresh: Chyba = Id mimo rozsah");
            return false;
          }
          break;
        case 2:
          if (fcMenu() == false) {
            Alarm.activated = true;
            Alarm.message->set_Message("Displej/Refresh: Error = Id out of range", "Displej/Refresh: Chyba = Id mimo rozsah");
            return false;
          }
          break;
        case 3:
          if (fcSettings() == false) {
            Alarm.activated = true;
            Alarm.message->set_Message("Displej/Refresh: Error = Id out of range", "Displej/Refresh: Chyba = Id mimo rozsah");
            return false;
          }
          break;
        case 10:
          if (fcHeating_circuit() == false) {
            Alarm.activated = true;
            Alarm.message->set_Message("Displej/Refresh: Error = Id out of range", "Displej/Refresh: Chyba = Id mimo rozsah");
            return false;
          }
          break;
        case 11:
          if (fcUltrasonic() == false) {
            Alarm.activated = true;
            Alarm.message->set_Message("Displej/Refresh: Error = Id out of range", "Displej/Refresh: Chyba = Id mimo rozsah");
            return false;
          }
          break;
        case 12:
          if (fcActive_cooling() == false) {
            Alarm.activated = true;
            Alarm.message->set_Message("Displej/Refresh: Error = Id out of range", "Displej/Refresh: Chyba = Id mimo rozsah");
            return false;
          }
          break;
        case 13:
          if (fcTime() == false) {
            Alarm.activated = true;
            Alarm.message->set_Message("Displej/Refresh: Error = Id out of range", "Displej/Refresh: Chyba = Id mimo rozsah");
            return false;
          }
          break;
        default:
          Alarm.activated = true;
          Alarm.message->set_Message("Displej/Refresh: Error = Page out of range", "Displej/Refresh: Chyba = Strana mimo rozsah");
          return false;
      }
    }
    return true;
  }
  void set_touch() {
    Touch.raw_Pressed = tft->getTouch(&Touch.x, &Touch.y);
  }
  void set_Current_mode(bool value) {
    if (value) Current_mode = Nominal_run;
    else Current_mode = Ground_position;
  }
  void set_Server_update_time(int value) {
    if ((value >= 10) && (value <= 40)) Server_update_time = value;
    else if (value < 10) Server_update_time = 10;
    else if (value > 40) Server_update_time = 40;
  }

  bool get_Alarm_activated() {
    return Alarm.activated;
  }
  String get_Alarm_message() {
    return Alarm.message->get_Message();
  }
  String get_Language_option() {
    return Message->get_language();
  }
  short get_Current_mode() {
    return Current_mode;
  }
  int get_Server_update_time() {
    return Server_update_time;
  }
  void set_Display_off() {
    Property.Brightness.Value = 0;
    ledcWrite(Property.Brightness.PWMChannel, Property.Brightness.Value);
  }

private:
  void touch_calibrate() {
    uint16_t calData[5];
    uint8_t calDataOK = 0;
    ledcWrite(Property.Brightness.PWMChannel, 200);

    // check file system exists
    if (!SPIFFS.begin()) {
      Serial.println("Formating file system");
      SPIFFS.format();
      SPIFFS.begin();
    }

    // check if calibration file exists and size is correct
    if (SPIFFS.exists(CALIBRATION_FILE)) {
      Serial.println("Check if calibration file exists and size is correct");
      if (REPEAT_CAL) {
        // Delete if we want to re-calibrate
        SPIFFS.remove(CALIBRATION_FILE);
      } else {
        File f = SPIFFS.open(CALIBRATION_FILE, "r");
        if (f) {
          if (f.readBytes((char*)calData, 14) == 14)
            calDataOK = 1;
          f.close();
        }
      }
    }

    if (calDataOK && !REPEAT_CAL) {
      // calibration data valid
      tft->setTouch(calData);
    } else {
      // data not valid so recalibrate
      tft->fillScreen(img->color565(Property.Color.Black[0], Property.Color.Black[1], Property.Color.Black[2]));
      tft->setCursor(20, 0);
      tft->setTextFont(2);
      tft->setTextSize(1);
      tft->setTextColor(img->color565(Property.Color.Text[0], Property.Color.Text[1], Property.Color.Text[2]), img->color565(Property.Color.Black[0], Property.Color.Black[1], Property.Color.Black[2]));

      tft->println("Touch corners as indicated");

      tft->setTextFont(1);
      tft->println();

      if (REPEAT_CAL) {
        tft->setTextColor(img->color565(Property.Color.Red[0], Property.Color.Red[1], Property.Color.Red[2]), img->color565(Property.Color.Black[0], Property.Color.Black[1], Property.Color.Black[2]));
        tft->println("Set REPEAT_CAL to false to stop this running again!");
      }

      tft->calibrateTouch(calData, img->color565(Property.Color.Red[0], Property.Color.Red[1], Property.Color.Red[2]), img->color565(Property.Color.Black[0], Property.Color.Black[1], Property.Color.Black[2]), 15);

      tft->setTextColor(img->color565(Property.Color.Green[0], Property.Color.Green[1], Property.Color.Green[2]), img->color565(Property.Color.Black[0], Property.Color.Black[1], Property.Color.Black[2]));
      tft->println("Calibration complete!");

      // store data
      File f = SPIFFS.open(CALIBRATION_FILE, "w");
      if (f) {
        f.write((const unsigned char*)calData, 14);
        f.close();
      }
    }
  }
  struct Touch_struct {
    uint16_t x, y;
    bool raw_Pressed;
    unsigned long UpdateTimeHMI_Touch;
    bool Pressed, prev_Pressed;
    int Pressing_period;
    bool Releast;
  };
  Touch_struct Touch;
  void Touch_detector() {

    //Make from non-static Touch signal static
    /*
    if (Touch.raw_Pressed) Touch.UpdateTimeHMI_Touch = millis() + (millis() - Property.Refresh_time);
    if (Touch.UpdateTimeHMI_Touch >= millis()) Touch.Pressed = true;
    else Touch.Pressed = false;
    */
    if (cooler->get_Temperature() >= 33) timer_for_touch.set_Time_LOOP_constant(400);
    else if (cooler->get_Temperature() >= 30) timer_for_touch.set_Time_LOOP_constant(300);
    if (Touch.raw_Pressed) {
      timer_for_touch.Timer(false);
      Touch.Pressed = true;
    } else {
      //timer_for_touch.set_Time_LOOP_constant(Property.Refresh_time);
      if (timer_for_touch.Timer(true)) Touch.Pressed = false;
    }

    //Waiting for releast from button
    if (Touch.prev_Pressed && Touch.Pressed == false) Touch.Releast = true;
    else Touch.Releast = false;

    Touch.prev_Pressed = Touch.Pressed;

    Faceplate->Set_datum(Touch.x, Touch.y, Touch.Pressed, Touch.Releast);

    if (Touch.Pressed && (Property.Pressing.Enable_timer == false)) {
      Property.Pressing.Enable_timer = true;
      Property.Pressing.Count = 800;
    } else if (Touch.Releast) {
      Property.Pressing.Enable_timer = false;
      Property.Pressing.Count = 800;
      Property.Pressing.Time = (millis() - Property.Pressing.Count);
    }
  }

private:
  struct Top_bar_struct {
    uint8_t Height;
    TON* TON_flashing_mode = new TON(700);
    bool Current_mode_flashing;
  };
  Top_bar_struct TopBar;
  bool fcTop_bar() {
    String String_convertor = "";
    if (page == Main_page) {
      Message->set_Message("Hlavna strana", "Main page");
      String_convertor = String(String_convertor + Message->get_Message());
      Faceplate->TextBox_main(Property.first_draw, true, String_convertor,
                              0, 0, 140, TopBar.Height, 0, 0, "",
                              Property.Color.White, 9, "ML", 5, TopBar.Height / 2,
                              Property.Color.Blue, Property.Color.Background,
                              Property.Color.Background, 0, Property.Rotation);
    } else if (page == Menu) {
      Message->set_Message("Menu", "Menu");
      String_convertor = String(String_convertor + Message->get_Message());
      Faceplate->TextBox_main(Property.first_draw, true, String_convertor,
                              0, 0, 140, TopBar.Height, 0, 0, "",
                              Property.Color.White, 9, "ML", 5, TopBar.Height / 2,
                              Property.Color.Blue, Property.Color.Background,
                              Property.Color.Background, 0, Property.Rotation);
      Faceplate->Reset_Scrools_TextBox();
    } else if (page == Settings) {
      Message->set_Message("Nastavenia", "Settings");
      String_convertor = String(String_convertor + Message->get_Message());
      Faceplate->TextBox_main(Property.first_draw, true, String_convertor,
                              0, 0, 140, TopBar.Height, 0, 0, "",
                              Property.Color.White, 9, "ML", 5, TopBar.Height / 2,
                              Property.Color.Blue, Property.Color.Background,
                              Property.Color.Background, 0, Property.Rotation);
    } else if (page == Heating_circruit_) {
      Message->set_Message("Menu", "Menu");
      String_convertor = String(String_convertor + Message->get_Message());
      String_convertor = String(String_convertor + "/");
      Message->set_Message("Vyhrevny okruh", "Heating circruit");
      String_convertor = String(String_convertor + Message->get_Message());
      Faceplate->Scrools_TextBox_main(String_convertor, 2, true, 3000,
                                      0, 0, 140, TopBar.Height, 0, -70,
                                      Property.Color.White, 9, "ML", 5, TopBar.Height / 2,
                                      Property.Color.Blue, Property.Color.Background,
                                      Property.Color.Background, 0, Property.Rotation);
    } else if (page == Ultrasonic_) {
      Message->set_Message("Menu", "Menu");
      String_convertor = String(String_convertor + Message->get_Message());
      String_convertor = String(String_convertor + "/");
      Message->set_Message("Ultrazvuk", "Ultrasonic");
      String_convertor = String(String_convertor + Message->get_Message());
      Faceplate->Scrools_TextBox_main(String_convertor, 2, true, 3000,
                                      0, 0, 140, TopBar.Height, 0, -20,
                                      Property.Color.White, 9, "ML", 5, TopBar.Height / 2,
                                      Property.Color.Blue, Property.Color.Background,
                                      Property.Color.Background, 0, Property.Rotation);
    } else if (page == Temperature_sensor_) {
      Message->set_Message("Menu", "Menu");
      String_convertor = String(String_convertor + Message->get_Message());
      String_convertor = String(String_convertor + "/");
      Message->set_Message("Chladit", "Cooling");
      String_convertor = String(String_convertor + Message->get_Message());
      Faceplate->TextBox_main(Property.first_draw, true, String_convertor,
                              0, 0, 140, TopBar.Height, 0, 0, "",
                              Property.Color.White, 9, "ML", 5, TopBar.Height / 2,
                              Property.Color.Blue, Property.Color.Background,
                              Property.Color.Background, 0, Property.Rotation);
    } else if (page == Time_) {
      Message->set_Message("Menu", "Menu");
      String_convertor = String(String_convertor + Message->get_Message());
      String_convertor = String(String_convertor + "/");
      Message->set_Message("Cas", "Time");
      String_convertor = String(String_convertor + Message->get_Message());
      Faceplate->TextBox_main(Property.first_draw, true, String_convertor,
                              0, 0, 140, TopBar.Height, 0, 0, "",
                              Property.Color.White, 9, "ML", 5, TopBar.Height / 2,
                              Property.Color.Blue, Property.Color.Background,
                              Property.Color.Background, 0, Property.Rotation);
    }

    if (Wifi_connection == 1) Faceplate->Icon_main(true, 140, 0, 44, 30, 32, 32, 6, -1, wifi_OK, Property.Color.Blue);
    else if (Wifi_connection == 2) Faceplate->Icon_main(true, 140, 0, 44, 30, 32, 32, 6, -1, wifi_lose, Property.Color.Blue);
    else if (Wifi_connection == 3) Faceplate->Icon_main(true, 140, 0, 44, 30, 32, 32, 6, -1, wifi_disable, Property.Color.Blue);

    if (TopBar.TON_flashing_mode->Timer(true)) {
      if (TopBar.Current_mode_flashing) TopBar.Current_mode_flashing = false;
      else TopBar.Current_mode_flashing = true;
    }

    if (TopBar.Current_mode_flashing) {
      if (Current_mode == Nominal_run) {
        Message->set_Message("Zapnuty", "Turn on");
        Faceplate->TextBox_main(Property.first_draw, true, Message->get_Message(),
                                184, 0, 131, TopBar.Height, 0, 0, "",
                                Property.Color.Green, 9, "Mc", 26, TopBar.Height / 2,
                                Property.Color.Blue, Property.Color.Background,
                                Property.Color.Background, 0, Property.Rotation);
      } else {
        Message->set_Message("Vypnuty", "Turn off");
        Faceplate->TextBox_main(Property.first_draw, true, Message->get_Message(),
                                184, 0, 131, TopBar.Height, 0, 0, "",
                                Property.Color.Red, 9, "Mc", 26, TopBar.Height / 2,
                                Property.Color.Blue, Property.Color.Background,
                                Property.Color.Background, 0, Property.Rotation);
      }
    }

    else {
      if (Current_mode == Nominal_run) Message->set_Message("Zapnuty", "Turn on");
      else Message->set_Message("Vypnuty", "Turn off");
      Faceplate->TextBox_main(Property.first_draw, true, Message->get_Message(),
                              184, 0, 131, TopBar.Height, 0, 0, "",
                              Property.Color.White, 9, "Mc", 26, TopBar.Height / 2,
                              Property.Color.Blue, Property.Color.Background,
                              Property.Color.Background, 0, Property.Rotation);
    }

    if (esp_now->get_Comunication(true)) {
      Faceplate->TextBox_main(Property.first_draw, true, "",
                              310, 0, 50, TopBar.Height, 0, 20, "",
                              Property.Color.White, 9, "MR", 135, TopBar.Height / 2,
                              Property.Color.Green, Property.Color.Green,
                              Property.Color.Blue, 8, Property.Rotation);
    } else {
      Faceplate->TextBox_main(Property.first_draw, true, "",
                              310, 0, 50, TopBar.Height, 0, 20, "",
                              Property.Color.White, 9, "MR", 135, TopBar.Height / 2,
                              Property.Color.Red, Property.Color.Red,
                              Property.Color.Blue, 8, Property.Rotation);
    }

    if (esp_now->get_Comunication(false)) {
      Faceplate->TextBox_main(Property.first_draw, true, "",
                              360, 0, 50, TopBar.Height, 0, 20, "",
                              Property.Color.White, 9, "MR", 135, TopBar.Height / 2,
                              Property.Color.Green, Property.Color.Green,
                              Property.Color.Blue, 8, Property.Rotation);
    } else {
      Faceplate->TextBox_main(Property.first_draw, true, "",
                              360, 0, 50, TopBar.Height, 0, 20, "",
                              Property.Color.White, 9, "MR", 135, TopBar.Height / 2,
                              Property.Color.Red, Property.Color.Red,
                              Property.Color.Blue, 8, Property.Rotation);
    }

    String_convertor = String(real_time->get_Real_hours(), DEC);
    String_convertor = String(String_convertor + ":");
    String String_convertor_auxiliary = String(real_time->get_Real_minutes(), DEC);
    if (real_time->get_Real_minutes() < 10) String_convertor = String(String_convertor + "0");
    String_convertor = String(String_convertor + String_convertor_auxiliary);
    Faceplate->TextBox_main(Property.first_draw, true, String_convertor,
                            405, 0, 75, TopBar.Height, 0, 0, "",
                            Property.Color.White, 9, "MR", 70, TopBar.Height / 2,
                            Property.Color.Blue, Property.Color.Background,
                            Property.Color.Background, 0, Property.Rotation);
    return true;
  }

private:
  struct Main_page_struct {
    int TON_wait_for_OFF_constant = 1000;
    TON* TON_wait_for_OFF = new TON(TON_wait_for_OFF_constant);
    int TON_wait_for_ON_constant = 1000;
    TON* TON_wait_for_ON = new TON(TON_wait_for_ON_constant);

    bool prev_heating_1 = false;
    bool prev_heating_2 = false;
  };
  Main_page_struct MainPage;
  bool fcMain_page() {
    if ((MainPage.prev_heating_1 != oven_1->get_Heating()) || (MainPage.prev_heating_2 != oven_2->get_Heating())) {
      Property.first_draw = true;
      MainPage.prev_heating_1 = oven_1->get_Heating();
      MainPage.prev_heating_2 = oven_2->get_Heating();
    }

    if (Current_mode == Nominal_run) {
      Message->set_Message("STOP", "STOP");
      if (Faceplate->Button_main(Property.first_draw, false, true, Message->get_Message(),
                                 325, 260, 150, 60, 10,
                                 Property.Color.Red, 12, "MC", 75, 30,
                                 Property.Color.Text, Property.Color.Background, Property.Color.Yellow,
                                 Property.Color.Red, 3, Property.Rotation)) {
        if (MainPage.TON_wait_for_OFF->Timer(true)) {
          Current_mode = Ground_position;
          MainPage.TON_wait_for_OFF->Timer(false);
          MainPage.TON_wait_for_ON->Timer(false);
        }
      } else MainPage.TON_wait_for_OFF->Timer(false);
    } else {
      Message->set_Message("START", "START");
      if (Faceplate->Button_main(Property.first_draw, false, true, Message->get_Message(),
                                 325, 260, 150, 60, 10,
                                 Property.Color.Green, 12, "MC", 75, 30,
                                 Property.Color.Text, Property.Color.Background, Property.Color.Yellow,
                                 Property.Color.Green, 3, Property.Rotation)) {
        if (MainPage.TON_wait_for_ON->Timer(true)) {
          Current_mode = Nominal_run;
          MainPage.TON_wait_for_ON->Timer(false);
          MainPage.TON_wait_for_OFF->Timer(false);
        }
      } else MainPage.TON_wait_for_ON->Timer(false);
    }
    Message->set_Message("MENU", "MENU");
    if (Current_mode == Ground_position) {
      if (Faceplate->Button_main(Property.first_draw, true, true, Message->get_Message(),
                                 165, 260, 150, 60, 10,
                                 Property.Color.Blue, 12, "MC", 75, 30,
                                 Property.Color.Text, Property.Color.Background, Property.Color.Focused,
                                 Property.Color.Blue, 3, Property.Rotation)) {
        Current_mode = Ground_position;
        page = Menu;
      }
    } else {
      if (Faceplate->Button_main(Property.first_draw, true, false, Message->get_Message(),
                                 165, 260, 150, 60, 10,
                                 Property.Color.Blue, 12, "MC", 75, 30,
                                 Property.Color.Background, Property.Color.Background, Property.Color.Focused,
                                 Property.Color.Blue, 3, Property.Rotation)) {
        Current_mode = Ground_position;
        page = Menu;
      }
    }

    Message->set_Message("NAST.", "SET.");
    if (Faceplate->Button_main(Property.first_draw, true, true, Message->get_Message(),
                               5, 260, 150, 60, 10,
                               Property.Color.Blue, 12, "MC", 75, 30,
                               Property.Color.Text, Property.Color.Background, Property.Color.Focused,
                               Property.Color.Blue, 3, Property.Rotation)) {
      page = Settings;
    }

    if (ultrasonic->get_Capacity_in_percent() <= 20) {
      Faceplate->Slider_main(ultrasonic->get_Capacity_in_percent(), true, false,
                             5, 50, 40, 190, 5,
                             Property.Color.Text, 9, "MC", 20, 95,
                             Property.Color.Background, Property.Color.Background, Property.Color.Red,
                             Property.Color.Text, 2, Property.Rotation);
    } else {
      Faceplate->Slider_main(ultrasonic->get_Capacity_in_percent(), true, false,
                             5, 50, 40, 190, 5,
                             Property.Color.Text, 9, "MC", 20, 95,
                             Property.Color.Background, Property.Color.Background, Property.Color.Green,
                             Property.Color.Text, 2, Property.Rotation);
    }

    String StringConvertor;
    String AuxiliaryStringConvertor;
    int temporary_X = -10;
    int temporary_X_2 = 205;
    int temporary_Y = 0;
    /////////////////////////////////////////////////////////////////////////////////////////Table: Circruit 1
    if (true) {
      Message->set_Message("Okruh 1", "Circruit 1");
      Faceplate->TextBox_main(Property.first_draw, false, Message->get_Message(),
                              temporary_X + 70, temporary_Y + 40, 200, 40, 5, 5, "TOP",
                              Property.Color.Text, 12, "ML", 15, 20,
                              Property.Color.Transparent, Property.Color.Background,
                              Property.Color.Text, 2, Property.Rotation);

      if (oven_1->get_Heating()) {
        //tft->pushImage(temporary_X+210, temporary_Y+43, 32, 32, Fire);
        Faceplate->Icon_main(Property.first_draw, temporary_X + 210, temporary_Y + 43, 32, 32, 32, 32, 0, 0, Fire, Property.Color.Background);
      } else {
        //tft->pushImage(temporary_X+210, temporary_Y+43, 32, 32, Flake);
        Faceplate->Icon_main(Property.first_draw, temporary_X + 210, temporary_Y + 43, 32, 32, 32, 32, 0, 0, Flake, Property.Color.Background);
      }

      Faceplate->TextBox_main(Property.first_draw, false, "",
                              temporary_X + 70, temporary_Y + 78, 200, 170, 5, 5, "BOTTOM",
                              Property.Color.Text, 9, "ML", 5, 15,
                              Property.Color.Transparent, Property.Color.Background,
                              Property.Color.Text, 2, Property.Rotation);

      StringConvertor = String(oven_1->get_Temperature(), 1);
      if (oven_1->get_Temperature() >= oven_1->get_Upper_limit()) {
        Faceplate->TextBox_main(Property.first_draw, false, StringConvertor,
                                temporary_X + 82, temporary_Y + 80, 120, 50, 0, 0, "",
                                Property.Color.Red, 24, "TR", 105, 5,
                                Property.Color.Background, Property.Color.Background,
                                Property.Color.White, 0, Property.Rotation);
      } else if (oven_1->get_Temperature() <= oven_1->get_Lower_limit()) {
        Faceplate->TextBox_main(Property.first_draw, false, StringConvertor,
                                temporary_X + 82, temporary_Y + 80, 120, 50, 0, 0, "",
                                Property.Color.Blue, 24, "TR", 105, 5,
                                Property.Color.Background, Property.Color.Background,
                                Property.Color.White, 0, Property.Rotation);
      } else {
        Faceplate->TextBox_main(Property.first_draw, false, StringConvertor,
                                temporary_X + 82, temporary_Y + 80, 120, 50, 0, 0, "",
                                Property.Color.Text, 24, "TR", 105, 5,
                                Property.Color.Background, Property.Color.Background,
                                Property.Color.White, 0, Property.Rotation);
      }

      Faceplate->degrees_Celsius(Property.first_draw,
                                 temporary_X + 202, temporary_Y + 85, 50, 45,
                                 Property.Color.Text, 24,
                                 8, Property.Rotation);

      StringConvertor = String(oven_1->get_Humidity(), 1);
      StringConvertor = String(StringConvertor + "%");
      Faceplate->TextBox_main(Property.first_draw, false, StringConvertor,
                              temporary_X + 153, temporary_Y + 130, 115, 40, 0, 0, "",
                              Property.Color.Text, 18, "MC", 57, 20,
                              Property.Color.Background, Property.Color.Background,
                              Property.Color.White, 0, Property.Rotation);


      if (Property.first_draw) {
        if (oven_1->get_Mode() == 0) {
          //tft->pushImage(temporary_X+85, temporary_Y+135, 32, 32, switch_off);
          Faceplate->Icon_main(Property.first_draw, temporary_X + 85, temporary_Y + 133, 64, 32, 64, 64, 0, -16, switch_off, Property.Color.Background);
        } else if (oven_1->get_Mode() == 1) {
          //tft->pushImage(temporary_X+85, temporary_Y+135, 32, 32, switch_on);
          Faceplate->Icon_main(Property.first_draw, temporary_X + 85, temporary_Y + 133, 64, 32, 64, 64, 0, -16, switch_on, Property.Color.Background);
        } else if (oven_1->get_Mode() == 2) {
          //tft->pushImage(temporary_X+85, temporary_Y+135, 32, 32, AutomaticMode);
          Faceplate->Icon_main(Property.first_draw, temporary_X + 85, temporary_Y + 133, 64, 32, 32, 32, 23, 0, AutomaticMode, Property.Color.Background);
        }
      }

      Message->set_Message("Pozadovana T:", "Required T:");
      Faceplate->TextBox_main(Property.first_draw, false, Message->get_Message(),
                              temporary_X + 72, temporary_Y + 172, 190, 25, 0, 0, "",
                              Property.Color.Text, 9, "ML", 5, 12,
                              Property.Color.Background, Property.Color.Background,
                              Property.Color.White, 0, Property.Rotation);

      StringConvertor = String(oven_1->get_Required_T(), 1);
      Faceplate->TextBox_main(Property.first_draw, false, StringConvertor,
                              temporary_X + 72, temporary_Y + 195, 80, 50, 5, 5, "",
                              Property.Color.Text, 18, "MR", 75, 25,
                              Property.Color.Background, Property.Color.Background,
                              Property.Color.White, 0, Property.Rotation);

      Faceplate->degrees_Celsius(Property.first_draw,
                                 temporary_X + 152, temporary_Y + 200, 35, 40,
                                 Property.Color.Text, 18,
                                 6, Property.Rotation);

      StringConvertor = String(oven_1->get_Positive_tolerance(), 1);
      StringConvertor = String("+ " + StringConvertor);
      Faceplate->TextBox_main(Property.first_draw, false, StringConvertor,
                              temporary_X + 188, temporary_Y + 192, 80, 25, 5, 5, "",
                              Property.Color.Text, 12, "MC", 40, 12,
                              Property.Color.Background, Property.Color.Background,
                              Property.Color.White, 0, Property.Rotation);

      StringConvertor = String(oven_1->get_Negative_tolerance(), 1);
      StringConvertor = String("- " + StringConvertor);
      Faceplate->TextBox_main(Property.first_draw, false, StringConvertor,
                              temporary_X + 188, temporary_Y + 217, 80, 25, 5, 5, "",
                              Property.Color.Text, 12, "MC", 40, 12,
                              Property.Color.Background, Property.Color.Background,
                              Property.Color.White, 0, Property.Rotation);
    }

    /////////////////////////////////////////////////////////////////////////////////////////Table: Circruit 2
    if (true) {
      Message->set_Message("Okruh 2", "Circruit 2");
      Faceplate->TextBox_main(Property.first_draw, false, Message->get_Message(),
                              temporary_X_2 + 70, temporary_Y + 40, 200, 40, 5, 5, "TOP",
                              Property.Color.Text, 12, "ML", 15, 20,
                              Property.Color.Transparent, Property.Color.Background,
                              Property.Color.Text, 2, Property.Rotation);

      if (oven_2->get_Heating()) {
        tft->pushImage(temporary_X_2 + 210, temporary_Y + 43, 32, 32, Fire);
      } else {
        tft->pushImage(temporary_X_2 + 210, temporary_Y + 43, 32, 32, Flake);
      }

      if (Property.first_draw) {
        if (oven_2->get_Mode() == 0) {
          //tft->pushImage(temporary_X+85, temporary_Y+135, 32, 32, switch_off);
          Faceplate->Icon_main(Property.first_draw, temporary_X_2 + 85, temporary_Y + 133, 64, 32, 64, 64, 0, -16, switch_off, Property.Color.Background);
        } else if (oven_2->get_Mode() == 1) {
          //tft->pushImage(temporary_X+85, temporary_Y+135, 32, 32, switch_on);
          Faceplate->Icon_main(Property.first_draw, temporary_X_2 + 85, temporary_Y + 133, 64, 32, 64, 64, 0, -16, switch_on, Property.Color.Background);
        } else if (oven_2->get_Mode() == 2) {
          //tft->pushImage(temporary_X+85, temporary_Y+135, 32, 32, AutomaticMode);
          Faceplate->Icon_main(Property.first_draw, temporary_X_2 + 85, temporary_Y + 133, 64, 32, 32, 32, 23, 0, AutomaticMode, Property.Color.Background);
        }
      }

      //It just draw rectangle
      Faceplate->TextBox_main(Property.first_draw, false, "",
                              temporary_X_2 + 70, temporary_Y + 78, 200, 170, 5, 5, "BOTTOM",
                              Property.Color.Text, 9, "ML", 5, 15,
                              Property.Color.Transparent, Property.Color.Background,
                              Property.Color.Text, 2, Property.Rotation);

      StringConvertor = String(oven_2->get_Temperature(), 1);
      if (oven_2->get_Temperature() >= oven_2->get_Upper_limit()) {
        Faceplate->TextBox_main(Property.first_draw, false, StringConvertor,
                                temporary_X_2 + 82, temporary_Y + 80, 120, 50, 0, 0, "",
                                Property.Color.Red, 24, "TR", 105, 5,
                                Property.Color.Background, Property.Color.Background,
                                Property.Color.White, 0, Property.Rotation);
      } else if (oven_2->get_Temperature() <= oven_2->get_Lower_limit()) {
        Faceplate->TextBox_main(Property.first_draw, false, StringConvertor,
                                temporary_X_2 + 82, temporary_Y + 80, 120, 50, 0, 0, "",
                                Property.Color.Blue, 24, "TR", 105, 5,
                                Property.Color.Background, Property.Color.Background,
                                Property.Color.White, 0, Property.Rotation);
      } else {
        Faceplate->TextBox_main(Property.first_draw, false, StringConvertor,
                                temporary_X_2 + 82, temporary_Y + 80, 120, 50, 0, 0, "",
                                Property.Color.Text, 24, "TR", 105, 5,
                                Property.Color.Background, Property.Color.Background,
                                Property.Color.White, 0, Property.Rotation);
      }

      Faceplate->degrees_Celsius(Property.first_draw,
                                 temporary_X_2 + 202, temporary_Y + 85, 50, 45,
                                 Property.Color.Text, 24,
                                 8, Property.Rotation);

      StringConvertor = String(oven_2->get_Humidity(), 1);
      StringConvertor = String(StringConvertor + "%");
      Faceplate->TextBox_main(Property.first_draw, false, StringConvertor,
                              temporary_X_2 + 153, temporary_Y + 130, 115, 40, 0, 0, "",
                              Property.Color.Text, 18, "MC", 57, 20,
                              Property.Color.Background, Property.Color.Background,
                              Property.Color.White, 0, Property.Rotation);


      Message->set_Message("Pozadovana T:", "Required T:");
      Faceplate->TextBox_main(Property.first_draw, false, Message->get_Message(),
                              temporary_X_2 + 72, temporary_Y + 172, 190, 25, 0, 0, "",
                              Property.Color.Text, 9, "ML", 5, 12,
                              Property.Color.Background, Property.Color.Background,
                              Property.Color.White, 0, Property.Rotation);

      StringConvertor = String(oven_2->get_Required_T(), 1);
      Faceplate->TextBox_main(Property.first_draw, false, StringConvertor,
                              temporary_X_2 + 72, temporary_Y + 195, 80, 50, 5, 5, "",
                              Property.Color.Text, 18, "MR", 75, 25,
                              Property.Color.Background, Property.Color.Background,
                              Property.Color.White, 0, Property.Rotation);

      Faceplate->degrees_Celsius(Property.first_draw,
                                 temporary_X_2 + 152, temporary_Y + 200, 35, 40,
                                 Property.Color.Text, 18,
                                 6, Property.Rotation);

      StringConvertor = String(oven_2->get_Positive_tolerance(), 1);
      StringConvertor = String("+ " + StringConvertor);
      Faceplate->TextBox_main(Property.first_draw, false, StringConvertor,
                              temporary_X_2 + 188, temporary_Y + 192, 80, 25, 5, 5, "",
                              Property.Color.Text, 12, "MC", 40, 12,
                              Property.Color.Background, Property.Color.Background,
                              Property.Color.White, 0, Property.Rotation);

      StringConvertor = String(oven_2->get_Negative_tolerance(), 1);
      StringConvertor = String("- " + StringConvertor);
      Faceplate->TextBox_main(Property.first_draw, false, StringConvertor,
                              temporary_X_2 + 188, temporary_Y + 217, 80, 25, 5, 5, "",
                              Property.Color.Text, 12, "MC", 40, 12,
                              Property.Color.Background, Property.Color.Background,
                              Property.Color.White, 0, Property.Rotation);
    }

    //Clear
    Faceplate->TextBox_main(Property.first_draw, true, "",
                            479, 319, 1, 1, 0, 0, "",
                            Property.Color.Background, 9, "MC", 1, 1,
                            Property.Color.Background, Property.Color.Background,
                            Property.Color.Background, 0, Property.Rotation);

    Property.first_draw = false;
    return true;
  }

  bool fcMenu() {
    Message->set_Message("Vyhrevny okruh", "Heating circruit");
    if (Faceplate->Button_main(Property.first_draw, true, true, Message->get_Message(),
                               10, 40, 460, 50, 10,
                               Property.Color.Blue, 12, "MC", 230, 25,
                               Property.Color.Text, Property.Color.Background, Property.Color.Focused,
                               Property.Color.Blue, 3, Property.Rotation)) {
      page = Heating_circruit_;
    }
    Message->set_Message("Ultrazvuk", "Ultrasonic");
    if (Faceplate->Button_main(Property.first_draw, true, true, Message->get_Message(),
                               10, 100, 460, 50, 10,
                               Property.Color.Blue, 12, "MC", 230, 25,
                               Property.Color.Text, Property.Color.Background, Property.Color.Focused,
                               Property.Color.Blue, 3, Property.Rotation)) {
      page = Ultrasonic_;
    }
    Message->set_Message("Chladenie", "Cooling");
    if (Faceplate->Button_main(Property.first_draw, true, true, Message->get_Message(),
                               10, 160, 460, 50, 10,
                               Property.Color.Blue, 12, "MC", 230, 25,
                               Property.Color.Text, Property.Color.Background, Property.Color.Focused,
                               Property.Color.Blue, 3, Property.Rotation)) {
      page = Temperature_sensor_;
    }
    Message->set_Message("Cas", "Time");
    if (Faceplate->Button_main(Property.first_draw, true, true, Message->get_Message(),
                               10, 220, 460, 50, 10,
                               Property.Color.Blue, 12, "MC", 230, 25,
                               Property.Color.Text, Property.Color.Background, Property.Color.Focused,
                               Property.Color.Blue, 3, Property.Rotation)) {
      page = Time_;
    }


    //Back button
    if (Faceplate->Icon_button_advance_main(Property.first_draw, true, BackBlue, BackGreen,
                                            0, 280, 480, 40, 32, 32, 224, 4, 20,
                                            Property.Color.Background, Property.Color.Background, Property.Color.Focused,
                                            Property.Color.Blue, 3, Property.Rotation)) {
      page = Main_page;
    }
    //Clear
    Faceplate->TextBox_main(Property.first_draw, true, "",
                            479, 319, 1, 1, 0, 0, "",
                            Property.Color.Background, 9, "MC", 1, 1,
                            Property.Color.Background, Property.Color.Background,
                            Property.Color.Background, 0, Property.Rotation);
    Property.first_draw = false;
    return true;
  }

  struct Settings_struct {
    String prev_language;
    int Reset_value;
  };
  Settings_struct Settings_str;
  bool fcSettings() {
    if (Settings_str.prev_language != Message->get_language()) {
      Settings_str.prev_language = Message->get_language();
      tft->fillScreen(tft->color565(Property.Color.Background[0], Property.Color.Background[1], Property.Color.Background[2]));
    }

    //Draw
    if (true) {
      Message->set_Message("Jazyk:", "Language:");
      Faceplate->TextBox_main(Property.first_draw, false, Message->get_Message(),
                              10, 40, 460, 40, 5, 5, "TOP",
                              Property.Color.Text, 9, "ML", 5, 20,
                              Property.Color.Transparent, Property.Color.Transparent,
                              Property.Color.Text, 2, Property.Rotation);

      Message->set_Message("Jas:", "Brightness:");
      Faceplate->TextBox_main(Property.first_draw, false, Message->get_Message(),
                              10, 78, 460, 60, 0, 0, "",
                              Property.Color.Text, 9, "ML", 5, 30,
                              Property.Color.Transparent, Property.Color.Transparent,
                              Property.Color.Text, 2, Property.Rotation);

      Message->set_Message("Rotacia:", "Rotation:");
      Faceplate->TextBox_main(Property.first_draw, false, Message->get_Message(),
                              10, 136, 460, 40, 0, 0, "",
                              Property.Color.Text, 9, "ML", 5, 20,
                              Property.Color.Transparent, Property.Color.Transparent,
                              Property.Color.Text, 2, Property.Rotation);

      Message->set_Message("Aktualizacia servra:", "Server update:");
      Faceplate->TextBox_main(Property.first_draw, false, Message->get_Message(),
                              10, 174, 460, 40, 0, 0, "",
                              Property.Color.Text, 9, "ML", 5, 20,
                              Property.Color.Transparent, Property.Color.Transparent,
                              Property.Color.Text, 2, Property.Rotation);

      Faceplate->TextBox_main(Property.first_draw, false, "",
                              10, 212, 460, 40, 5, 5, "BOTTOM",
                              Property.Color.Text, 9, "ML", 5, 20,
                              Property.Color.Transparent, Property.Color.Transparent,
                              Property.Color.Text, 2, Property.Rotation);
    }

    //Active
    if (true) {
      if (Message->get_language() == "SK") {
        Message->set_Message("SK", "SK");
        if (Faceplate->Button_main(Property.first_draw, true, true, Message->get_Message(),
                                   200, 42, 100, 36, 5,
                                   Property.Color.Green, 12, "MC", 50, 18,
                                   Property.Color.Background, Property.Color.Background, Property.Color.Green,
                                   Property.Color.Green, 3, Property.Rotation)) {
          Message->Set_language("SK");
        }
        Message->set_Message("EN", "EN");
        if (Faceplate->Button_main(Property.first_draw, true, true, Message->get_Message(),
                                   360, 42, 100, 36, 5,
                                   Property.Color.Red, 12, "MC", 50, 18,
                                   Property.Color.Background, Property.Color.Background, Property.Color.Focused,
                                   Property.Color.Red, 3, Property.Rotation)) {
          Message->Set_language("EN");
        }
      } else {
        Message->set_Message("SK", "SK");
        if (Faceplate->Button_main(Property.first_draw, true, true, Message->get_Message(),
                                   200, 42, 100, 36, 5,
                                   Property.Color.Red, 12, "MC", 50, 18,
                                   Property.Color.Background, Property.Color.Background, Property.Color.Focused,
                                   Property.Color.Red, 3, Property.Rotation)) {
          Message->Set_language("SK");
        }
        Message->set_Message("EN", "EN");
        if (Faceplate->Button_main(Property.first_draw, true, true, Message->get_Message(),
                                   360, 42, 100, 36, 5,
                                   Property.Color.Green, 12, "MC", 50, 18,
                                   Property.Color.Background, Property.Color.Background, Property.Color.Green,
                                   Property.Color.Green, 3, Property.Rotation)) {
          Message->Set_language("EN");
        }
      }
      int Brightness_Value = map(Property.Brightness.Value, 0, 255, 0, 100);
      Brightness_Value = map(Faceplate->Slider_main(Brightness_Value, false, true,
                                                    200, 80, 260, 56, 5,
                                                    Property.Color.Text, 9, "MC", 130, 28,
                                                    Property.Color.Background, Property.Color.Background, Property.Color.Green,
                                                    Property.Color.Text, 4, Property.Rotation),
                             0, 100, 1, 255);

      Property.Brightness.Value = Brightness_Value;

      bool Enable_draw = true;
      do {
        Enable_draw = true;
        if (Property.Rotation == 3) {
          Message->set_Message("UP", "UP");
          if (Faceplate->Button_main(Property.first_draw, true, true, Message->get_Message(),
                                     200, 138, 100, 36, 5,
                                     Property.Color.Green, 12, "MC", 50, 18,
                                     Property.Color.Background, Property.Color.Background, Property.Color.Green,
                                     Property.Color.Green, 3, Property.Rotation)) {
          }
          Message->set_Message("DOWN", "DOWN");
          if (Faceplate->Button_main(Property.first_draw, true, true, Message->get_Message(),
                                     360, 138, 100, 36, 5,
                                     Property.Color.Red, 12, "MC", 50, 18,
                                     Property.Color.Background, Property.Color.Background, Property.Color.Green,
                                     Property.Color.Red, 3, Property.Rotation)) {
            REPEAT_CAL = true;
            Property.Rotation = 1;
            flash->set_Flash(45, REPEAT_CAL);
            flash->set_Flash(44, Property.Rotation);
            ESP.restart();
          }
        } else {
          Message->set_Message("UP", "UP");
          if (Faceplate->Button_main(Property.first_draw, true, true, Message->get_Message(),
                                     360, 138, 100, 36, 5,
                                     Property.Color.Green, 12, "MC", 50, 18,
                                     Property.Color.Background, Property.Color.Background, Property.Color.Green,
                                     Property.Color.Green, 3, Property.Rotation)) {
          }
          Message->set_Message("DOWN", "DOWN");
          if (Faceplate->Button_main(Property.first_draw, true, true, Message->get_Message(),
                                     200, 138, 100, 36, 5,
                                     Property.Color.Red, 12, "MC", 50, 18,
                                     Property.Color.Background, Property.Color.Background, Property.Color.Green,
                                     Property.Color.Red, 3, Property.Rotation)) {
            REPEAT_CAL = true;
            Property.Rotation = 3;
            flash->set_Flash(45, REPEAT_CAL);
            flash->set_Flash(44, Property.Rotation);
            ESP.restart();
          }
        }
      } while (Enable_draw == false);


      Faceplate->TextBox_main(Property.first_draw || Touch.Releast, false, (((String)Server_update_time) + "m"),
                              300, 176, 60, 36, 0, 0, "",
                              Property.Color.Text, 12, "MC", 30, 18,
                              Property.Color.Black, Property.Color.Black,
                              Property.Color.Black, 2, Property.Rotation);

      if (Faceplate->Button_main(Property.first_draw, false, true, "+",
                                 216, 176, 70, 36, 5,
                                 Property.Color.Red, 18, "MC", 35, 13,
                                 Property.Color.Background, Property.Color.Background, Property.Color.Yellow,
                                 Property.Color.Red, 3, Property.Rotation)) {
        Property.Pressing.ID = 64;
        Faceplate->TextBox_main(true, true, (((String)Server_update_time) + "m"),
                                300, 176, 60, 36, 0, 0, "",
                                Property.Color.Text, 12, "MC", 30, 18,
                                Property.Color.Black, Property.Color.Black,
                                Property.Color.Black, 2, Property.Rotation);
      }
      if (Faceplate->Button_main(Property.first_draw, false, true, "-",
                                 386, 176, 70, 36, 5,
                                 Property.Color.Red, 18, "MC", 35, 13,
                                 Property.Color.Background, Property.Color.Background, Property.Color.Yellow,
                                 Property.Color.Red, 3, Property.Rotation)) {
        Property.Pressing.ID = 65;
        Faceplate->TextBox_main(true, true, (((String)Server_update_time) + "m"),
                                300, 176, 60, 36, 0, 0, "",
                                Property.Color.Text, 12, "MC", 30, 18,
                                Property.Color.Black, Property.Color.Black,
                                Property.Color.Black, 2, Property.Rotation);
      }

      if (Faceplate->Button_main(Property.first_draw, true, true, "RESET",
                                 12, 214, 150, 36, 5,
                                 Property.Color.Red, 12, "MC", 75, 18,
                                 Property.Color.Background, Property.Color.Background, Property.Color.Green,
                                 Property.Color.Red, 3, Property.Rotation)) {

        if(Settings_str.Reset_value == 1) cooler->Reset();
        else if(Settings_str.Reset_value == 2) {
          oven_1->Reset();
          oven_2->Reset();
        }
        else if(Settings_str.Reset_value == 3) real_time->Reset();
        else if(Settings_str.Reset_value == 4) ultrasonic->Reset();
      }
      
      if(Settings_str.Reset_value == 1) Message->set_Message("Chladic", "Cooler");
      else if(Settings_str.Reset_value == 2) Message->set_Message("Okruhy", "Circuits");
      else if(Settings_str.Reset_value == 3) Message->set_Message("Cas", "Time");
      else if(Settings_str.Reset_value == 4) Message->set_Message("Ultrazvuk", "Ultrasonic");

      Faceplate->TextBox_main(Property.first_draw || Touch.Releast, false, Message->get_Message(),
                              200, 214, 150, 36, 5, 5, "",
                              Property.Color.Text, 12, "MC", 75, 18,
                              Property.Color.Black, Property.Color.Black,
                              Property.Color.Black, 2, Property.Rotation);

      if (Faceplate->Button_main(Property.first_draw, false, true, ">",
                                 386, 214, 70, 36, 5,
                                 Property.Color.Red, 18, "MC", 35, 14,
                                 Property.Color.Background, Property.Color.Background, Property.Color.Green,
                                 Property.Color.Red, 3, Property.Rotation)) {
        Property.Pressing.ID = 66;
        Faceplate->TextBox_main(true, true, Message->get_Message(),
                                200, 214, 150, 36, 5, 5, "",
                                Property.Color.Text, 12, "MC", 75, 18,
                                Property.Color.Black, Property.Color.Black,
                                Property.Color.Black, 2, Property.Rotation);
      }
      
    }

    //Back button
    if (Faceplate->Icon_button_advance_main(Property.first_draw, true, BackBlue, BackGreen,
                                            0, 280, 480, 40, 32, 32, 224, 4, 20,
                                            Property.Color.Background, Property.Color.Background, Property.Color.Focused,
                                            Property.Color.Blue, 3, Property.Rotation)) {
      page = Main_page;
    }
    //Clear
    Faceplate->TextBox_main(Property.first_draw, true, "",
                            479, 319, 1, 1, 0, 0, "",
                            Property.Color.Background, 9, "MC", 1, 1,
                            Property.Color.Background, Property.Color.Background,
                            Property.Color.Background, 0, Property.Rotation);
    return true;
  }

  struct Heating_circruit_struct {
    bool Circuit;
    bool prev_Circuit;
    bool Enable_draw;
    int Page;
  };
  Heating_circruit_struct Heating_circuit;
  bool fcHeating_circuit() {
    if (Heating_circuit.prev_Circuit != Heating_circuit.Circuit) {
      Heating_circuit.prev_Circuit = Heating_circuit.Circuit;
      tft->fillScreen(tft->color565(Property.Color.Background[0], Property.Color.Background[1], Property.Color.Background[2]));
      Property.first_draw = true;
    }

    Oven* oven;

    if (Heating_circuit.Circuit) {
      oven = oven_1;
      Message->set_Message("Okruh 1", "Circuit 1");
      if (oven_1->get_Enable_heating()) {
        if (Faceplate->Button_main(Property.first_draw, true, true, Message->get_Message(),
                                   0, 30, 240, 40, 0,
                                   Property.Color.Green, 12, "MC", 120, 20,
                                   Property.Color.Black, Property.Color.Background, Property.Color.Green,
                                   Property.Color.Black, 0, Property.Rotation)) {
        }
      } else {
        if (Faceplate->Button_main(Property.first_draw, true, true, Message->get_Message(),
                                   0, 30, 240, 40, 0,
                                   Property.Color.Red, 12, "MC", 120, 20,
                                   Property.Color.Black, Property.Color.Background, Property.Color.Red,
                                   Property.Color.Black, 0, Property.Rotation)) {
        }
      }
      Message->set_Message("Okruh 2", "Circuit 2");
      if (oven_2->get_Enable_heating()) {
        if (Faceplate->Button_main(Property.first_draw, true, true, Message->get_Message(),
                                   240, 30, 240, 40, 0,
                                   Property.Color.Green, 12, "MC", 120, 20,
                                   Property.Color.Dark_blue, Property.Color.Background, Property.Color.Green,
                                   Property.Color.Dark_blue, 3, Property.Rotation)) {
          Heating_circuit.Circuit = false;
          Property.first_draw = true;
        }
      } else {
        if (Faceplate->Button_main(Property.first_draw, true, true, Message->get_Message(),
                                   240, 30, 240, 40, 0,
                                   Property.Color.Red, 12, "MC", 120, 20,
                                   Property.Color.Dark_blue, Property.Color.Background, Property.Color.Red,
                                   Property.Color.Dark_blue, 3, Property.Rotation)) {
          Heating_circuit.Circuit = false;
          Property.first_draw = true;
        }
      }
    } else {
      oven = oven_2;
      Message->set_Message("Okruh 2", "Circuit 2");
      if (oven_2->get_Enable_heating()) {
        if (Faceplate->Button_main(Property.first_draw, true, true, Message->get_Message(),
                                   240, 30, 240, 40, 0,
                                   Property.Color.Green, 12, "MC", 120, 20,
                                   Property.Color.Black, Property.Color.Background, Property.Color.Green,
                                   Property.Color.Black, 0, Property.Rotation)) {
        }
      } else {
        if (Faceplate->Button_main(Property.first_draw, true, true, Message->get_Message(),
                                   240, 30, 240, 40, 0,
                                   Property.Color.Red, 12, "MC", 120, 20,
                                   Property.Color.Black, Property.Color.Background, Property.Color.Red,
                                   Property.Color.Black, 0, Property.Rotation)) {
        }
      }
      Message->set_Message("Okruh 1", "Circuit 1");
      if (oven_1->get_Enable_heating()) {
        if (Faceplate->Button_main(Property.first_draw, true, true, Message->get_Message(),
                                   0, 30, 240, 40, 0,
                                   Property.Color.Green, 12, "MC", 120, 20,
                                   Property.Color.Dark_blue, Property.Color.Background, Property.Color.Green,
                                   Property.Color.Dark_blue, 3, Property.Rotation)) {
          Heating_circuit.Circuit = true;
          Property.first_draw = true;
        }
      } else {
        if (Faceplate->Button_main(Property.first_draw, true, true, Message->get_Message(),
                                   0, 30, 240, 40, 0,
                                   Property.Color.Red, 12, "MC", 120, 20,
                                   Property.Color.Dark_blue, Property.Color.Background, Property.Color.Red,
                                   Property.Color.Dark_blue, 3, Property.Rotation)) {
          Heating_circuit.Circuit = true;
          Property.first_draw = true;
        }
      }
    }

    if (Heating_circuit.Page == 1) {
      //Draw
      if (true) {
        Message->set_Message("Okruh:", "Circruit:");
        Faceplate->TextBox_main(Property.first_draw, false, Message->get_Message(),
                                5, 80, 470, 40, 10, 10, "TOP",
                                Property.Color.Text, 9, "ML", 5, 20,
                                Property.Color.Transparent, Property.Color.Transparent,
                                Property.Color.Text, 2, Property.Rotation);

        Message->set_Message("Rezim:", "Mode:");
        Faceplate->TextBox_main(Property.first_draw, false, Message->get_Message(),
                                5, 118, 470, 40, 0, 0, "",
                                Property.Color.Text, 9, "ML", 5, 20,
                                Property.Color.Transparent, Property.Color.Transparent,
                                Property.Color.Text, 2, Property.Rotation);

        Message->set_Message("Pozadovana teplota:", "Required temperature:");
        Faceplate->TextBox_main(Property.first_draw, false, Message->get_Message(),
                                5, 156, 470, 40, 0, 0, "",
                                Property.Color.Text, 9, "ML", 5, 20,
                                Property.Color.Transparent, Property.Color.Transparent,
                                Property.Color.Text, 2, Property.Rotation);

        Message->set_Message("Kladna tolerancia:", "Positive tolerance:");
        Faceplate->TextBox_main(Property.first_draw, false, Message->get_Message(),
                                5, 194, 470, 40, 0, 0, "",
                                Property.Color.Text, 9, "ML", 5, 20,
                                Property.Color.Transparent, Property.Color.Transparent,
                                Property.Color.Text, 2, Property.Rotation);

        Message->set_Message("Zaporna tolerancia:", "Negative tolerance:");
        Faceplate->TextBox_main(Property.first_draw, false, Message->get_Message(),
                                5, 232, 470, 40, 10, 10, "BOTTOM",
                                Property.Color.Text, 9, "ML", 5, 20,
                                Property.Color.Transparent, Property.Color.Transparent,
                                Property.Color.Text, 2, Property.Rotation);
      }
      //Active part
      if (true) {
        do {
          Heating_circuit.Enable_draw = true;
          Message->set_Message("ON", "ON");
          if (oven->get_Enable_heating()) {
            if (Faceplate->Button_main(Property.first_draw, true, true, Message->get_Message(),
                                       180, 82, 100, 36, 5,
                                       Property.Color.Green, 12, "MC", 50, 18,
                                       Property.Color.Background, Property.Color.Background, Property.Color.Green,
                                       Property.Color.Green, 3, Property.Rotation)) {
            }
            Message->set_Message("OFF", "OFF");
            if (Faceplate->Button_main(Property.first_draw, true, true, Message->get_Message(),
                                       360, 82, 100, 36, 5,
                                       Property.Color.Red, 12, "MC", 50, 18,
                                       Property.Color.Background, Property.Color.Background, Property.Color.Green,
                                       Property.Color.Red, 3, Property.Rotation)) {
              oven->set_Enable_heating(false);
              Heating_circuit.Enable_draw = false;
            }
          } else {
            Message->set_Message("OFF", "OFF");
            if (Faceplate->Button_main(Property.first_draw, true, true, Message->get_Message(),
                                       360, 82, 100, 36, 5,
                                       Property.Color.Green, 12, "MC", 50, 18,
                                       Property.Color.Background, Property.Color.Background, Property.Color.Green,
                                       Property.Color.Green, 3, Property.Rotation)) {
            }
            Message->set_Message("ON", "ON");
            if (Faceplate->Button_main(Property.first_draw, true, true, Message->get_Message(),
                                       180, 82, 100, 36, 5,
                                       Property.Color.Red, 12, "MC", 50, 18,
                                       Property.Color.Background, Property.Color.Background, Property.Color.Green,
                                       Property.Color.Red, 3, Property.Rotation)) {
              oven->set_Enable_heating(true);
              Heating_circuit.Enable_draw = false;
            }
          }

        } while (Heating_circuit.Enable_draw == false);

        do {
          Heating_circuit.Enable_draw = true;
          if (oven->get_Mode() == 0) {
            Message->set_Message("ON", "ON");
            if (Faceplate->Button_main(Property.first_draw, true, true, Message->get_Message(),
                                       180, 120, 83, 36, 5,
                                       Property.Color.Red, 12, "MC", 41, 18,
                                       Property.Color.Background, Property.Color.Background, Property.Color.Green,
                                       Property.Color.Red, 3, Property.Rotation)) {
              oven->set_Mode(1);
              Heating_circuit.Enable_draw = false;
            }
            Message->set_Message("AUTO", "AUTO");
            if (Faceplate->Button_main(Property.first_draw || Heating_circuit.Enable_draw, true, true, Message->get_Message(),
                                       278, 120, 83, 36, 5,
                                       Property.Color.Red, 12, "MC", 41, 18,
                                       Property.Color.Background, Property.Color.Background, Property.Color.Green,
                                       Property.Color.Red, 3, Property.Rotation)) {
              oven->set_Mode(2);
              Heating_circuit.Enable_draw = false;
            }
            Message->set_Message("OFF", "OFF");
            if (Faceplate->Button_main(Property.first_draw || Heating_circuit.Enable_draw, true, true, Message->get_Message(),
                                       376, 120, 83, 36, 5,
                                       Property.Color.Green, 12, "MC", 41, 18,
                                       Property.Color.Background, Property.Color.Background, Property.Color.Green,
                                       Property.Color.Green, 3, Property.Rotation)) {
            }
          } else if (oven->get_Mode() == 1) {
            Message->set_Message("ON", "ON");
            if (Faceplate->Button_main(Property.first_draw, true, true, Message->get_Message(),
                                       180, 120, 83, 36, 5,
                                       Property.Color.Green, 12, "MC", 41, 18,
                                       Property.Color.Background, Property.Color.Background, Property.Color.Green,
                                       Property.Color.Green, 3, Property.Rotation)) {
            }
            Message->set_Message("AUTO", "AUTO");
            if (Faceplate->Button_main(Property.first_draw, true, true, Message->get_Message(),
                                       278, 120, 83, 36, 5,
                                       Property.Color.Red, 12, "MC", 41, 18,
                                       Property.Color.Background, Property.Color.Background, Property.Color.Green,
                                       Property.Color.Red, 3, Property.Rotation)) {
              oven->set_Mode(2);
              Heating_circuit.Enable_draw = false;
            }
            Message->set_Message("OFF", "OFF");
            if (Faceplate->Button_main(Property.first_draw, true, true, Message->get_Message(),
                                       376, 120, 83, 36, 5,
                                       Property.Color.Red, 12, "MC", 41, 18,
                                       Property.Color.Background, Property.Color.Background, Property.Color.Green,
                                       Property.Color.Red, 3, Property.Rotation)) {
              oven->set_Mode(0);
              Heating_circuit.Enable_draw = false;
            }
          } else if (oven->get_Mode() == 2) {
            Message->set_Message("ON", "ON");
            if (Faceplate->Button_main(Property.first_draw, true, true, Message->get_Message(),
                                       180, 120, 83, 36, 5,
                                       Property.Color.Red, 12, "MC", 41, 18,
                                       Property.Color.Background, Property.Color.Background, Property.Color.Green,
                                       Property.Color.Red, 3, Property.Rotation)) {
              oven->set_Mode(1);
              Heating_circuit.Enable_draw = false;
            }
            Message->set_Message("AUTO", "AUTO");
            if (Faceplate->Button_main(Property.first_draw, true, true, Message->get_Message(),
                                       278, 120, 83, 36, 5,
                                       Property.Color.Green, 12, "MC", 41, 18,
                                       Property.Color.Background, Property.Color.Background, Property.Color.Green,
                                       Property.Color.Green, 3, Property.Rotation)) {
            }
            Message->set_Message("OFF", "OFF");
            if (Faceplate->Button_main(Property.first_draw, true, true, Message->get_Message(),
                                       376, 120, 83, 36, 5,
                                       Property.Color.Red, 12, "MC", 41, 18,
                                       Property.Color.Background, Property.Color.Background, Property.Color.Green,
                                       Property.Color.Red, 3, Property.Rotation)) {
              oven->set_Mode(0);
              Heating_circuit.Enable_draw = false;
            }
          }
        } while (Heating_circuit.Enable_draw == false);

        Faceplate->TextBox_main(Property.first_draw || Touch.Releast, false, (String)oven->get_Required_T(),
                                300, 158, 60, 36, 0, 0, "",
                                Property.Color.Text, 12, "MC", 30, 18,
                                Property.Color.Black, Property.Color.Black,
                                Property.Color.Black, 2, Property.Rotation);

        if (Faceplate->Button_main(Property.first_draw, false, true, "+",
                                   216, 158, 70, 36, 5,
                                   Property.Color.Red, 18, "MC", 35, 13,
                                   Property.Color.Background, Property.Color.Background, Property.Color.Yellow,
                                   Property.Color.Red, 3, Property.Rotation)) {
          Property.Pressing.ID = 1;
          Faceplate->TextBox_main(true, true, (String)oven->get_Required_T(),
                                  300, 158, 60, 36, 0, 0, "",
                                  Property.Color.Text, 12, "MC", 30, 18,
                                  Property.Color.Black, Property.Color.Black,
                                  Property.Color.Black, 2, Property.Rotation);
        }
        if (Faceplate->Button_main(Property.first_draw, false, true, "-",
                                   386, 158, 70, 36, 5,
                                   Property.Color.Red, 18, "MC", 35, 13,
                                   Property.Color.Background, Property.Color.Background, Property.Color.Yellow,
                                   Property.Color.Red, 3, Property.Rotation)) {
          Property.Pressing.ID = 2;
          Faceplate->TextBox_main(true, true, (String)oven->get_Required_T(),
                                  300, 158, 60, 36, 0, 0, "",
                                  Property.Color.Text, 12, "MC", 30, 18,
                                  Property.Color.Black, Property.Color.Black,
                                  Property.Color.Black, 2, Property.Rotation);
        }

        Faceplate->TextBox_main(Property.first_draw || Touch.Releast, false, (String)oven->get_Positive_tolerance(),
                                300, 196, 60, 36, 0, 0, "",
                                Property.Color.Text, 12, "MC", 30, 18,
                                Property.Color.Black, Property.Color.Black,
                                Property.Color.Black, 2, Property.Rotation);

        if (Faceplate->Button_main(Property.first_draw, false, true, "+",
                                   216, 196, 70, 36, 5,
                                   Property.Color.Red, 18, "MC", 35, 13,
                                   Property.Color.Background, Property.Color.Background, Property.Color.Yellow,
                                   Property.Color.Red, 3, Property.Rotation)) {
          Property.Pressing.ID = 3;
          Faceplate->TextBox_main(true, true, (String)oven->get_Positive_tolerance(),
                                  300, 196, 60, 36, 0, 0, "",
                                  Property.Color.Text, 12, "MC", 30, 18,
                                  Property.Color.Black, Property.Color.Black,
                                  Property.Color.Black, 2, Property.Rotation);
        }
        if (Faceplate->Button_main(Property.first_draw, false, true, "-",
                                   386, 196, 70, 36, 5,
                                   Property.Color.Red, 18, "MC", 35, 13,
                                   Property.Color.Background, Property.Color.Background, Property.Color.Yellow,
                                   Property.Color.Red, 3, Property.Rotation)) {
          Property.Pressing.ID = 4;
          Faceplate->TextBox_main(true, true, (String)oven->get_Positive_tolerance(),
                                  300, 196, 60, 36, 0, 0, "",
                                  Property.Color.Text, 12, "MC", 30, 18,
                                  Property.Color.Black, Property.Color.Black,
                                  Property.Color.Black, 2, Property.Rotation);
        }

        Faceplate->TextBox_main(Property.first_draw || Touch.Releast, false, (String)oven->get_Negative_tolerance(),
                                300, 234, 60, 36, 0, 0, "",
                                Property.Color.Text, 12, "MC", 30, 18,
                                Property.Color.Black, Property.Color.Black,
                                Property.Color.Black, 2, Property.Rotation);

        if (Faceplate->Button_main(Property.first_draw, false, true, "+",
                                   216, 234, 70, 36, 5,
                                   Property.Color.Red, 18, "MC", 35, 13,
                                   Property.Color.Background, Property.Color.Background, Property.Color.Yellow,
                                   Property.Color.Red, 3, Property.Rotation)) {
          Property.Pressing.ID = 5;
          Faceplate->TextBox_main(true, true, (String)oven->get_Negative_tolerance(),
                                  300, 234, 60, 36, 0, 0, "",
                                  Property.Color.Text, 12, "MC", 30, 18,
                                  Property.Color.Black, Property.Color.Black,
                                  Property.Color.Black, 2, Property.Rotation);
        }
        if (Faceplate->Button_main(Property.first_draw, false, true, "-",
                                   386, 234, 70, 36, 5,
                                   Property.Color.Red, 18, "MC", 35, 13,
                                   Property.Color.Background, Property.Color.Background, Property.Color.Yellow,
                                   Property.Color.Red, 3, Property.Rotation)) {
          Property.Pressing.ID = 6;
          Faceplate->TextBox_main(true, true, (String)oven->get_Negative_tolerance(),
                                  300, 234, 60, 36, 0, 0, "",
                                  Property.Color.Text, 12, "MC", 30, 18,
                                  Property.Color.Black, Property.Color.Black,
                                  Property.Color.Black, 2, Property.Rotation);
        }

        //Back button
        if (Faceplate->Icon_button_advance_main(Property.first_draw, true, BackBlue, BackGreen,
                                                0, 280, 235, 40, 32, 32, 100, 4, 20,
                                                Property.Color.Background, Property.Color.Background, Property.Color.Focused,
                                                Property.Color.Blue, 3, Property.Rotation)) {
          page = Menu;
        }
        if (Faceplate->Icon_button_advance_main(Property.first_draw, true, right_chevron, right_chevronGreen,
                                                245, 280, 235, 40, 32, 32, 100, 4, 20,
                                                Property.Color.Background, Property.Color.Background, Property.Color.Focused,
                                                Property.Color.Blue, 3, Property.Rotation)) {
          Heating_circuit.Page = 2;
          //for refresh
          prev_page = Main_page;
        }
      }
    } else if (Heating_circuit.Page == 2) {
      //Draw part
      if (true) {
        Message->set_Message("Upozornenie VT:", "Warning HT");
        Faceplate->TextBox_main(Property.first_draw, false, Message->get_Message(),
                                5, 80, 470, 40, 10, 10, "TOP",
                                Property.Color.Text, 9, "ML", 5, 20,
                                Property.Color.Transparent, Property.Color.Transparent,
                                Property.Color.Text, 2, Property.Rotation);

        Message->set_Message("Upozornenie NT", "Warning LT:");
        Faceplate->TextBox_main(Property.first_draw, false, Message->get_Message(),
                                5, 118, 470, 40, 0, 0, "",
                                Property.Color.Text, 9, "ML", 5, 20,
                                Property.Color.Transparent, Property.Color.Transparent,
                                Property.Color.Text, 2, Property.Rotation);

        Message->set_Message("PID:", "PID:");
        Faceplate->TextBox_main(Property.first_draw, false, Message->get_Message(),
                                5, 156, 470, 40, 0, 0, "",
                                Property.Color.Text, 9, "ML", 5, 20,
                                Property.Color.Transparent, Property.Color.Transparent,
                                Property.Color.Text, 2, Property.Rotation);

        Message->set_Message("Rezim PID:", "Mode PID:");
        Faceplate->TextBox_main(Property.first_draw, false, Message->get_Message(),
                                5, 194, 470, 40, 0, 0, "",
                                Property.Color.Text, 9, "ML", 5, 20,
                                Property.Color.Transparent, Property.Color.Transparent,
                                Property.Color.Text, 2, Property.Rotation);

        Message->set_Message("Interval:", "Interval:");
        Faceplate->TextBox_main(Property.first_draw, false, Message->get_Message(),
                                5, 232, 470, 40, 10, 10, "BOTTOM",
                                Property.Color.Text, 9, "ML", 5, 20,
                                Property.Color.Transparent, Property.Color.Transparent,
                                Property.Color.Text, 2, Property.Rotation);
      }
      //Active part
      if (true) {
        Faceplate->TextBox_main(Property.first_draw || Touch.Releast, false, (String)oven->get_Upper_limit(),
                                300, 82, 60, 36, 0, 0, "",
                                Property.Color.Text, 12, "MC", 30, 18,
                                Property.Color.Black, Property.Color.Black,
                                Property.Color.Black, 2, Property.Rotation);

        if (Faceplate->Button_main(Property.first_draw, false, true, "+",
                                   216, 82, 70, 36, 5,
                                   Property.Color.Red, 18, "MC", 35, 13,
                                   Property.Color.Background, Property.Color.Background, Property.Color.Yellow,
                                   Property.Color.Red, 3, Property.Rotation)) {
          Property.Pressing.ID = 7;
          Faceplate->TextBox_main(true, true, (String)oven->get_Upper_limit(),
                                  300, 82, 60, 36, 0, 0, "",
                                  Property.Color.Text, 12, "MC", 30, 18,
                                  Property.Color.Black, Property.Color.Black,
                                  Property.Color.Black, 2, Property.Rotation);
        }
        if (Faceplate->Button_main(Property.first_draw, false, true, "-",
                                   386, 82, 70, 36, 5,
                                   Property.Color.Red, 18, "MC", 35, 13,
                                   Property.Color.Background, Property.Color.Background, Property.Color.Yellow,
                                   Property.Color.Red, 3, Property.Rotation)) {
          Property.Pressing.ID = 8;
          Faceplate->TextBox_main(true, true, (String)oven->get_Upper_limit(),
                                  300, 82, 60, 36, 0, 0, "",
                                  Property.Color.Text, 12, "MC", 30, 18,
                                  Property.Color.Black, Property.Color.Black,
                                  Property.Color.Black, 2, Property.Rotation);
        }

        Faceplate->TextBox_main(Property.first_draw || Touch.Releast, false, (String)oven->get_Lower_limit(),
                                300, 120, 60, 36, 0, 0, "",
                                Property.Color.Text, 12, "MC", 30, 18,
                                Property.Color.Black, Property.Color.Black,
                                Property.Color.Black, 2, Property.Rotation);

        if (Faceplate->Button_main(Property.first_draw, false, true, "+",
                                   216, 120, 70, 36, 5,
                                   Property.Color.Red, 18, "MC", 35, 13,
                                   Property.Color.Background, Property.Color.Background, Property.Color.Yellow,
                                   Property.Color.Red, 3, Property.Rotation)) {
          Property.Pressing.ID = 9;
          Faceplate->TextBox_main(true, true, (String)oven->get_Lower_limit(),
                                  300, 120, 60, 36, 0, 0, "",
                                  Property.Color.Text, 12, "MC", 30, 18,
                                  Property.Color.Black, Property.Color.Black,
                                  Property.Color.Black, 2, Property.Rotation);
        }
        if (Faceplate->Button_main(Property.first_draw, false, true, "-",
                                   386, 120, 70, 36, 5,
                                   Property.Color.Red, 18, "MC", 35, 13,
                                   Property.Color.Background, Property.Color.Background, Property.Color.Yellow,
                                   Property.Color.Red, 3, Property.Rotation)) {
          Property.Pressing.ID = 10;
          Faceplate->TextBox_main(true, true, (String)oven->get_Lower_limit(),
                                  300, 120, 60, 36, 0, 0, "",
                                  Property.Color.Text, 12, "MC", 30, 18,
                                  Property.Color.Black, Property.Color.Black,
                                  Property.Color.Black, 2, Property.Rotation);
        }
        do {
          Heating_circuit.Enable_draw = true;
          Message->set_Message("ON", "ON");
          if (oven->get_PID_Mode() != 0) {
            if (Faceplate->Button_main(Property.first_draw, true, true, Message->get_Message(),
                                       180, 158, 100, 36, 5,
                                       Property.Color.Green, 12, "MC", 50, 18,
                                       Property.Color.Background, Property.Color.Background, Property.Color.Green,
                                       Property.Color.Green, 3, Property.Rotation)) {
            }
            Message->set_Message("OFF", "OFF");
            if (Faceplate->Button_main(Property.first_draw, true, true, Message->get_Message(),
                                       360, 158, 100, 36, 5,
                                       Property.Color.Red, 12, "MC", 50, 18,
                                       Property.Color.Background, Property.Color.Background, Property.Color.Green,
                                       Property.Color.Red, 3, Property.Rotation)) {
              oven->set_PID_Mode(0);
              Heating_circuit.Enable_draw = false;
              //for refresh
              prev_page = Main_page;
            }
          } else {
            Message->set_Message("OFF", "OFF");
            if (Faceplate->Button_main(Property.first_draw, true, true, Message->get_Message(),
                                       360, 158, 100, 36, 5,
                                       Property.Color.Green, 12, "MC", 50, 18,
                                       Property.Color.Background, Property.Color.Background, Property.Color.Green,
                                       Property.Color.Green, 3, Property.Rotation)) {
            }
            Message->set_Message("ON", "ON");
            if (Faceplate->Button_main(Property.first_draw, true, true, Message->get_Message(),
                                       180, 158, 100, 36, 5,
                                       Property.Color.Red, 12, "MC", 50, 18,
                                       Property.Color.Background, Property.Color.Background, Property.Color.Green,
                                       Property.Color.Red, 3, Property.Rotation)) {
              oven->set_PID_Mode(1);
              Heating_circuit.Enable_draw = false;
              //for refresh
              prev_page = Main_page;
            }
          }

        } while (Heating_circuit.Enable_draw == false);

        if (oven->get_PID_Mode() != 0) {
          do {
            Heating_circuit.Enable_draw = true;
            if (oven->get_PID_Mode() == 3) {
              Message->set_Message("LOW", "LOW");
              if (Faceplate->Button_main(Property.first_draw, true, true, Message->get_Message(),
                                         180, 196, 83, 36, 5,
                                         Property.Color.Red, 12, "MC", 41, 18,
                                         Property.Color.Background, Property.Color.Background, Property.Color.Green,
                                         Property.Color.Red, 3, Property.Rotation)) {
                oven->set_PID_Mode(1);
                Heating_circuit.Enable_draw = false;
              }
              Message->set_Message("MID", "MID");
              if (Faceplate->Button_main(Property.first_draw || Heating_circuit.Enable_draw, true, true, Message->get_Message(),
                                         278, 196, 83, 36, 5,
                                         Property.Color.Red, 12, "MC", 41, 18,
                                         Property.Color.Background, Property.Color.Background, Property.Color.Green,
                                         Property.Color.Red, 3, Property.Rotation)) {
                oven->set_PID_Mode(2);
                Heating_circuit.Enable_draw = false;
              }
              Message->set_Message("HIGH", "HIGH");
              if (Faceplate->Button_main(Property.first_draw || Heating_circuit.Enable_draw, true, true, Message->get_Message(),
                                         376, 196, 83, 36, 5,
                                         Property.Color.Green, 12, "MC", 41, 18,
                                         Property.Color.Background, Property.Color.Background, Property.Color.Green,
                                         Property.Color.Green, 3, Property.Rotation)) {
              }
            } else if (oven->get_PID_Mode() == 1) {
              Message->set_Message("LOW", "LOW");
              if (Faceplate->Button_main(Property.first_draw, true, true, Message->get_Message(),
                                         180, 196, 83, 36, 5,
                                         Property.Color.Green, 12, "MC", 41, 18,
                                         Property.Color.Background, Property.Color.Background, Property.Color.Green,
                                         Property.Color.Green, 3, Property.Rotation)) {
              }
              Message->set_Message("MID", "MID");
              if (Faceplate->Button_main(Property.first_draw, true, true, Message->get_Message(),
                                         278, 196, 83, 36, 5,
                                         Property.Color.Red, 12, "MC", 41, 18,
                                         Property.Color.Background, Property.Color.Background, Property.Color.Green,
                                         Property.Color.Red, 3, Property.Rotation)) {
                oven->set_PID_Mode(2);
                Heating_circuit.Enable_draw = false;
              }
              Message->set_Message("HIGH", "HIGH");
              if (Faceplate->Button_main(Property.first_draw, true, true, Message->get_Message(),
                                         376, 196, 83, 36, 5,
                                         Property.Color.Red, 12, "MC", 41, 18,
                                         Property.Color.Background, Property.Color.Background, Property.Color.Green,
                                         Property.Color.Red, 3, Property.Rotation)) {
                oven->set_PID_Mode(3);
                Heating_circuit.Enable_draw = false;
              }
            } else if (oven->get_PID_Mode() == 2) {
              Message->set_Message("LOW", "LOW");
              if (Faceplate->Button_main(Property.first_draw, true, true, Message->get_Message(),
                                         180, 196, 83, 36, 5,
                                         Property.Color.Red, 12, "MC", 41, 18,
                                         Property.Color.Background, Property.Color.Background, Property.Color.Green,
                                         Property.Color.Red, 3, Property.Rotation)) {
                oven->set_PID_Mode(1);
                Heating_circuit.Enable_draw = false;
              }
              Message->set_Message("MID", "MID");
              if (Faceplate->Button_main(Property.first_draw, true, true, Message->get_Message(),
                                         278, 196, 83, 36, 5,
                                         Property.Color.Green, 12, "MC", 41, 18,
                                         Property.Color.Background, Property.Color.Background, Property.Color.Green,
                                         Property.Color.Green, 3, Property.Rotation)) {
              }
              Message->set_Message("HIGH", "HIGH");
              if (Faceplate->Button_main(Property.first_draw, true, true, Message->get_Message(),
                                         376, 196, 83, 36, 5,
                                         Property.Color.Red, 12, "MC", 41, 18,
                                         Property.Color.Background, Property.Color.Background, Property.Color.Green,
                                         Property.Color.Red, 3, Property.Rotation)) {
                oven->set_PID_Mode(3);
                Heating_circuit.Enable_draw = false;
              }
            }
          } while (Heating_circuit.Enable_draw == false);
        } else {
          Message->set_Message("LOW", "LOW");
          if (Faceplate->Button_main(Property.first_draw, true, false, Message->get_Message(),
                                     180, 196, 83, 36, 5,
                                     Property.Color.Red, 12, "MC", 41, 18,
                                     Property.Color.Background, Property.Color.Background, Property.Color.Green,
                                     Property.Color.Red, 3, Property.Rotation)) {
          }
          Message->set_Message("MID", "MID");
          if (Faceplate->Button_main(Property.first_draw, true, false, Message->get_Message(),
                                     278, 196, 83, 36, 5,
                                     Property.Color.Green, 12, "MC", 41, 18,
                                     Property.Color.Background, Property.Color.Background, Property.Color.Green,
                                     Property.Color.Green, 3, Property.Rotation)) {
          }
          Message->set_Message("HIGH", "HIGH");
          if (Faceplate->Button_main(Property.first_draw, true, false, Message->get_Message(),
                                     376, 196, 83, 36, 5,
                                     Property.Color.Red, 12, "MC", 41, 18,
                                     Property.Color.Background, Property.Color.Background, Property.Color.Green,
                                     Property.Color.Red, 3, Property.Rotation)) {
          }
        }

        String String_Convertor = String(oven->get_Heating_Interval());
        if (oven->get_Heating_Interval() == 31) String_Convertor = "ALL";

        Faceplate->TextBox_main(Property.first_draw || Touch.Releast, false, String_Convertor,
                                300, 234, 60, 36, 0, 0, "",
                                Property.Color.Text, 12, "MC", 30, 18,
                                Property.Color.Black, Property.Color.Black,
                                Property.Color.Black, 2, Property.Rotation);

        if (Faceplate->Button_main(Property.first_draw, false, true, "+",
                                   216, 234, 70, 36, 5,
                                   Property.Color.Red, 18, "MC", 35, 13,
                                   Property.Color.Background, Property.Color.Background, Property.Color.Yellow,
                                   Property.Color.Red, 3, Property.Rotation)) {
          Property.Pressing.ID = 42;
          Faceplate->TextBox_main(true, true, String_Convertor,
                                  300, 234, 60, 36, 0, 0, "",
                                  Property.Color.Text, 12, "MC", 30, 18,
                                  Property.Color.Black, Property.Color.Black,
                                  Property.Color.Black, 2, Property.Rotation);
        }
        if (Faceplate->Button_main(Property.first_draw, false, true, "-",
                                   386, 234, 70, 36, 5,
                                   Property.Color.Red, 18, "MC", 35, 13,
                                   Property.Color.Background, Property.Color.Background, Property.Color.Yellow,
                                   Property.Color.Red, 3, Property.Rotation)) {
          Property.Pressing.ID = 43;
          Faceplate->TextBox_main(true, true, String_Convertor,
                                  300, 234, 60, 36, 0, 0, "",
                                  Property.Color.Text, 12, "MC", 30, 18,
                                  Property.Color.Black, Property.Color.Black,
                                  Property.Color.Black, 2, Property.Rotation);
        }

        if (Faceplate->Icon_button_advance_main(Property.first_draw, true, left_chevron, left_chevronGreen,
                                                0, 280, 235, 40, 32, 32, 100, 4, 20,
                                                Property.Color.Background, Property.Color.Background, Property.Color.Focused,
                                                Property.Color.Blue, 3, Property.Rotation)) {
          Heating_circuit.Page = 1;
          //for refresh
          prev_page = Main_page;
        }

        if (Faceplate->Icon_button_advance_main(Property.first_draw, true, right_chevron, right_chevronGreen,
                                                245, 280, 235, 40, 32, 32, 100, 4, 20,
                                                Property.Color.Background, Property.Color.Background, Property.Color.Focused,
                                                Property.Color.Blue, 3, Property.Rotation)) {
          Heating_circuit.Page = 3;
          //for refresh
          prev_page = Main_page;
        }
      }
    } else if (Heating_circuit.Page == 3) {
      //Draw part
      if (true) {
        Message->set_Message("Urdziavat teplotu:", "Maintain Temp.:");
        Faceplate->TextBox_main(Property.first_draw, false, Message->get_Message(),
                                5, 80, 470, 40, 10, 10, "TOP",
                                Property.Color.Text, 9, "ML", 5, 20,
                                Property.Color.Transparent, Property.Color.Transparent,
                                Property.Color.Text, 2, Property.Rotation);

        Message->set_Message("Pozadovana off T:", "Required off Temp:");
        Faceplate->TextBox_main(Property.first_draw, false, Message->get_Message(),
                                5, 118, 470, 40, 0, 0, "",
                                Property.Color.Text, 9, "ML", 5, 20,
                                Property.Color.Transparent, Property.Color.Transparent,
                                Property.Color.Text, 2, Property.Rotation);

        Message->set_Message("Kladna off tol.:", "Positive off tol.:");
        Faceplate->TextBox_main(Property.first_draw, false, Message->get_Message(),
                                5, 156, 470, 40, 0, 0, "",
                                Property.Color.Text, 9, "ML", 5, 20,
                                Property.Color.Transparent, Property.Color.Transparent,
                                Property.Color.Text, 2, Property.Rotation);

        Message->set_Message("Zaporna off tol.:", "Negative off tol.:");
        Faceplate->TextBox_main(Property.first_draw, false, Message->get_Message(),
                                5, 194, 470, 40, 0, 0, "",
                                Property.Color.Text, 9, "ML", 5, 20,
                                Property.Color.Transparent, Property.Color.Transparent,
                                Property.Color.Text, 2, Property.Rotation);

        Message->set_Message("Kontakt:", "Contact:");
        Faceplate->TextBox_main(Property.first_draw, false, Message->get_Message(),
                                5, 232, 470, 40, 10, 10, "BOTTOM",
                                Property.Color.Text, 9, "ML", 5, 20,
                                Property.Color.Transparent, Property.Color.Transparent,
                                Property.Color.Text, 2, Property.Rotation);
      }
      //Active part
      if (true) {
        do {
          Heating_circuit.Enable_draw = true;
          Message->set_Message("ON", "ON");
          if (oven->get_Enable_heating_off()) {
            if (Faceplate->Button_main(Property.first_draw, true, true, Message->get_Message(),
                                       180, 82, 100, 36, 5,
                                       Property.Color.Green, 12, "MC", 50, 18,
                                       Property.Color.Background, Property.Color.Background, Property.Color.Green,
                                       Property.Color.Green, 3, Property.Rotation)) {
            }
            Message->set_Message("OFF", "OFF");
            if (Faceplate->Button_main(Property.first_draw, true, true, Message->get_Message(),
                                       360, 82, 100, 36, 5,
                                       Property.Color.Red, 12, "MC", 50, 18,
                                       Property.Color.Background, Property.Color.Background, Property.Color.Green,
                                       Property.Color.Red, 3, Property.Rotation)) {
              oven->set_Enable_heating_off(false);
              Heating_circuit.Enable_draw = false;
            }
          } else {
            Message->set_Message("OFF", "OFF");
            if (Faceplate->Button_main(Property.first_draw, true, true, Message->get_Message(),
                                       360, 82, 100, 36, 5,
                                       Property.Color.Green, 12, "MC", 50, 18,
                                       Property.Color.Background, Property.Color.Background, Property.Color.Green,
                                       Property.Color.Green, 3, Property.Rotation)) {
            }
            Message->set_Message("ON", "ON");
            if (Faceplate->Button_main(Property.first_draw, true, true, Message->get_Message(),
                                       180, 82, 100, 36, 5,
                                       Property.Color.Red, 12, "MC", 50, 18,
                                       Property.Color.Background, Property.Color.Background, Property.Color.Green,
                                       Property.Color.Red, 3, Property.Rotation)) {
              oven->set_Enable_heating_off(true);
              Heating_circuit.Enable_draw = false;
            }
          }
        } while (Heating_circuit.Enable_draw == false);

        do {
          Heating_circuit.Enable_draw = true;
          Message->set_Message("NO", "NO");
          if (oven->get_NO_contact()) {
            if (Faceplate->Button_main(Property.first_draw, true, true, Message->get_Message(),
                                       180, 234, 100, 36, 5,
                                       Property.Color.Green, 12, "MC", 50, 18,
                                       Property.Color.Background, Property.Color.Background, Property.Color.Green,
                                       Property.Color.Green, 3, Property.Rotation)) {
            }
            Message->set_Message("NC", "NC");
            if (Faceplate->Button_main(Property.first_draw, true, true, Message->get_Message(),
                                       360, 234, 100, 36, 5,
                                       Property.Color.Red, 12, "MC", 50, 18,
                                       Property.Color.Background, Property.Color.Background, Property.Color.Green,
                                       Property.Color.Red, 3, Property.Rotation)) {
              oven->set_NO_contact(false);
              Heating_circuit.Enable_draw = false;
            }
          } else {
            Message->set_Message("NC", "NC");
            if (Faceplate->Button_main(Property.first_draw, true, true, Message->get_Message(),
                                       360, 234, 100, 36, 5,
                                       Property.Color.Green, 12, "MC", 50, 18,
                                       Property.Color.Background, Property.Color.Background, Property.Color.Green,
                                       Property.Color.Green, 3, Property.Rotation)) {
            }
            Message->set_Message("NO", "NO");
            if (Faceplate->Button_main(Property.first_draw, true, true, Message->get_Message(),
                                       180, 234, 100, 36, 5,
                                       Property.Color.Red, 12, "MC", 50, 18,
                                       Property.Color.Background, Property.Color.Background, Property.Color.Green,
                                       Property.Color.Red, 3, Property.Rotation)) {
              oven->set_NO_contact(true);
              Heating_circuit.Enable_draw = false;
            }
          }
        } while (Heating_circuit.Enable_draw == false);

        Faceplate->TextBox_main(Property.first_draw || Touch.Releast, false, (String)oven->get_Required_T_off(),
                                300, 120, 60, 36, 0, 0, "",
                                Property.Color.Text, 12, "MC", 30, 18,
                                Property.Color.Black, Property.Color.Black,
                                Property.Color.Black, 2, Property.Rotation);

        if (Faceplate->Button_main(Property.first_draw, false, true, "+",
                                   216, 120, 70, 36, 5,
                                   Property.Color.Red, 18, "MC", 35, 13,
                                   Property.Color.Background, Property.Color.Background, Property.Color.Yellow,
                                   Property.Color.Red, 3, Property.Rotation)) {
          Property.Pressing.ID = 46;
          Faceplate->TextBox_main(true, true, (String)oven->get_Required_T_off(),
                                  300, 120, 60, 36, 0, 0, "",
                                  Property.Color.Text, 12, "MC", 30, 18,
                                  Property.Color.Black, Property.Color.Black,
                                  Property.Color.Black, 2, Property.Rotation);
        }
        if (Faceplate->Button_main(Property.first_draw, false, true, "-",
                                   386, 120, 70, 36, 5,
                                   Property.Color.Red, 18, "MC", 35, 13,
                                   Property.Color.Background, Property.Color.Background, Property.Color.Yellow,
                                   Property.Color.Red, 3, Property.Rotation)) {
          Property.Pressing.ID = 47;
          Faceplate->TextBox_main(true, true, (String)oven->get_Required_T_off(),
                                  300, 120, 60, 36, 0, 0, "",
                                  Property.Color.Text, 12, "MC", 30, 18,
                                  Property.Color.Black, Property.Color.Black,
                                  Property.Color.Black, 2, Property.Rotation);
        }

        Faceplate->TextBox_main(Property.first_draw || Touch.Releast, false, (String)oven->get_Positive_tolerance_off(),
                                300, 158, 60, 36, 0, 0, "",
                                Property.Color.Text, 12, "MC", 30, 18,
                                Property.Color.Black, Property.Color.Black,
                                Property.Color.Black, 2, Property.Rotation);

        if (Faceplate->Button_main(Property.first_draw, false, true, "+",
                                   216, 158, 70, 36, 5,
                                   Property.Color.Red, 18, "MC", 35, 13,
                                   Property.Color.Background, Property.Color.Background, Property.Color.Yellow,
                                   Property.Color.Red, 3, Property.Rotation)) {
          Property.Pressing.ID = 48;
          Faceplate->TextBox_main(true, true, (String)oven->get_Positive_tolerance_off(),
                                  300, 158, 60, 36, 0, 0, "",
                                  Property.Color.Text, 12, "MC", 30, 18,
                                  Property.Color.Black, Property.Color.Black,
                                  Property.Color.Black, 2, Property.Rotation);
        }
        if (Faceplate->Button_main(Property.first_draw, false, true, "-",
                                   386, 158, 70, 36, 5,
                                   Property.Color.Red, 18, "MC", 35, 13,
                                   Property.Color.Background, Property.Color.Background, Property.Color.Yellow,
                                   Property.Color.Red, 3, Property.Rotation)) {
          Property.Pressing.ID = 49;
          Faceplate->TextBox_main(true, true, (String)oven->get_Positive_tolerance_off(),
                                  300, 158, 60, 36, 0, 0, "",
                                  Property.Color.Text, 12, "MC", 30, 18,
                                  Property.Color.Black, Property.Color.Black,
                                  Property.Color.Black, 2, Property.Rotation);
        }

        Faceplate->TextBox_main(Property.first_draw || Touch.Releast, false, (String)oven->get_Negative_tolerance_off(),
                                300, 196, 60, 36, 0, 0, "",
                                Property.Color.Text, 12, "MC", 30, 18,
                                Property.Color.Black, Property.Color.Black,
                                Property.Color.Black, 2, Property.Rotation);

        if (Faceplate->Button_main(Property.first_draw, false, true, "+",
                                   216, 196, 70, 36, 5,
                                   Property.Color.Red, 18, "MC", 35, 13,
                                   Property.Color.Background, Property.Color.Background, Property.Color.Yellow,
                                   Property.Color.Red, 3, Property.Rotation)) {
          Property.Pressing.ID = 50;
          Faceplate->TextBox_main(true, true, (String)oven->get_Negative_tolerance_off(),
                                  300, 196, 60, 36, 0, 0, "",
                                  Property.Color.Text, 12, "MC", 30, 18,
                                  Property.Color.Black, Property.Color.Black,
                                  Property.Color.Black, 2, Property.Rotation);
        }
        if (Faceplate->Button_main(Property.first_draw, false, true, "-",
                                   386, 196, 70, 36, 5,
                                   Property.Color.Red, 18, "MC", 35, 13,
                                   Property.Color.Background, Property.Color.Background, Property.Color.Yellow,
                                   Property.Color.Red, 3, Property.Rotation)) {
          Property.Pressing.ID = 51;
          Faceplate->TextBox_main(true, true, (String)oven->get_Negative_tolerance_off(),
                                  300, 196, 60, 36, 0, 0, "",
                                  Property.Color.Text, 12, "MC", 30, 18,
                                  Property.Color.Black, Property.Color.Black,
                                  Property.Color.Black, 2, Property.Rotation);
        }
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
